Beirdo/arduino-webasto-mainboard/README.md

# arduino-webasto-mainboard
Custom replacement control board for Webasto Thermo Top C/E
