Beirdo/arduino-webasto-mainboard/firmware/webasto-mainboard/src/README.md

Along with the libraries included under this directory, the following
must be added in the Arduino IDE:

Boards:
- Raspberry Pi Pico/RP2040 by Earle F. Philhower III - v2.7.1
- choose Raspberry Pi Pico W

Libraries:
- Queue by SMFSW <xgarmanbozlax@gmail.com> - v1.11.0
- I2C\_EEPROM by Rob Tillaart <rob.tillaart@gmail.com> - v1.7.1
- ArduinoLog by Thijs Elenbaas - v1.1.1
- TinyCBOR by TOKITA Hiroshi - v0.5.3002
- SSD1306 stuff
- ACAN2517FD by Pierre Molinaro - v2.1.10

also, to populate this directory, you need:
- git submodule init
- get submodule update

Please don't forget to enable RTTI in the Tools menu.
