Beirdo/arduino-webasto-mainboard/docs/20230128_150927.jpg

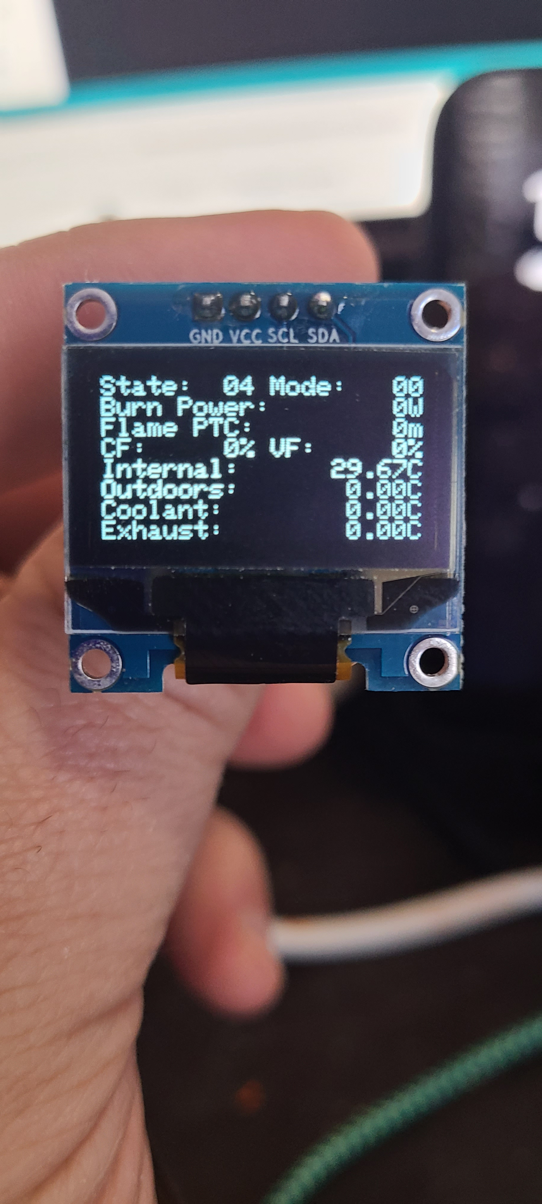
docs/20230128_150927.jpg
