Beirdo/arduino-webasto-mainboard/hardware/atx-power-fixture/schematic.pdf

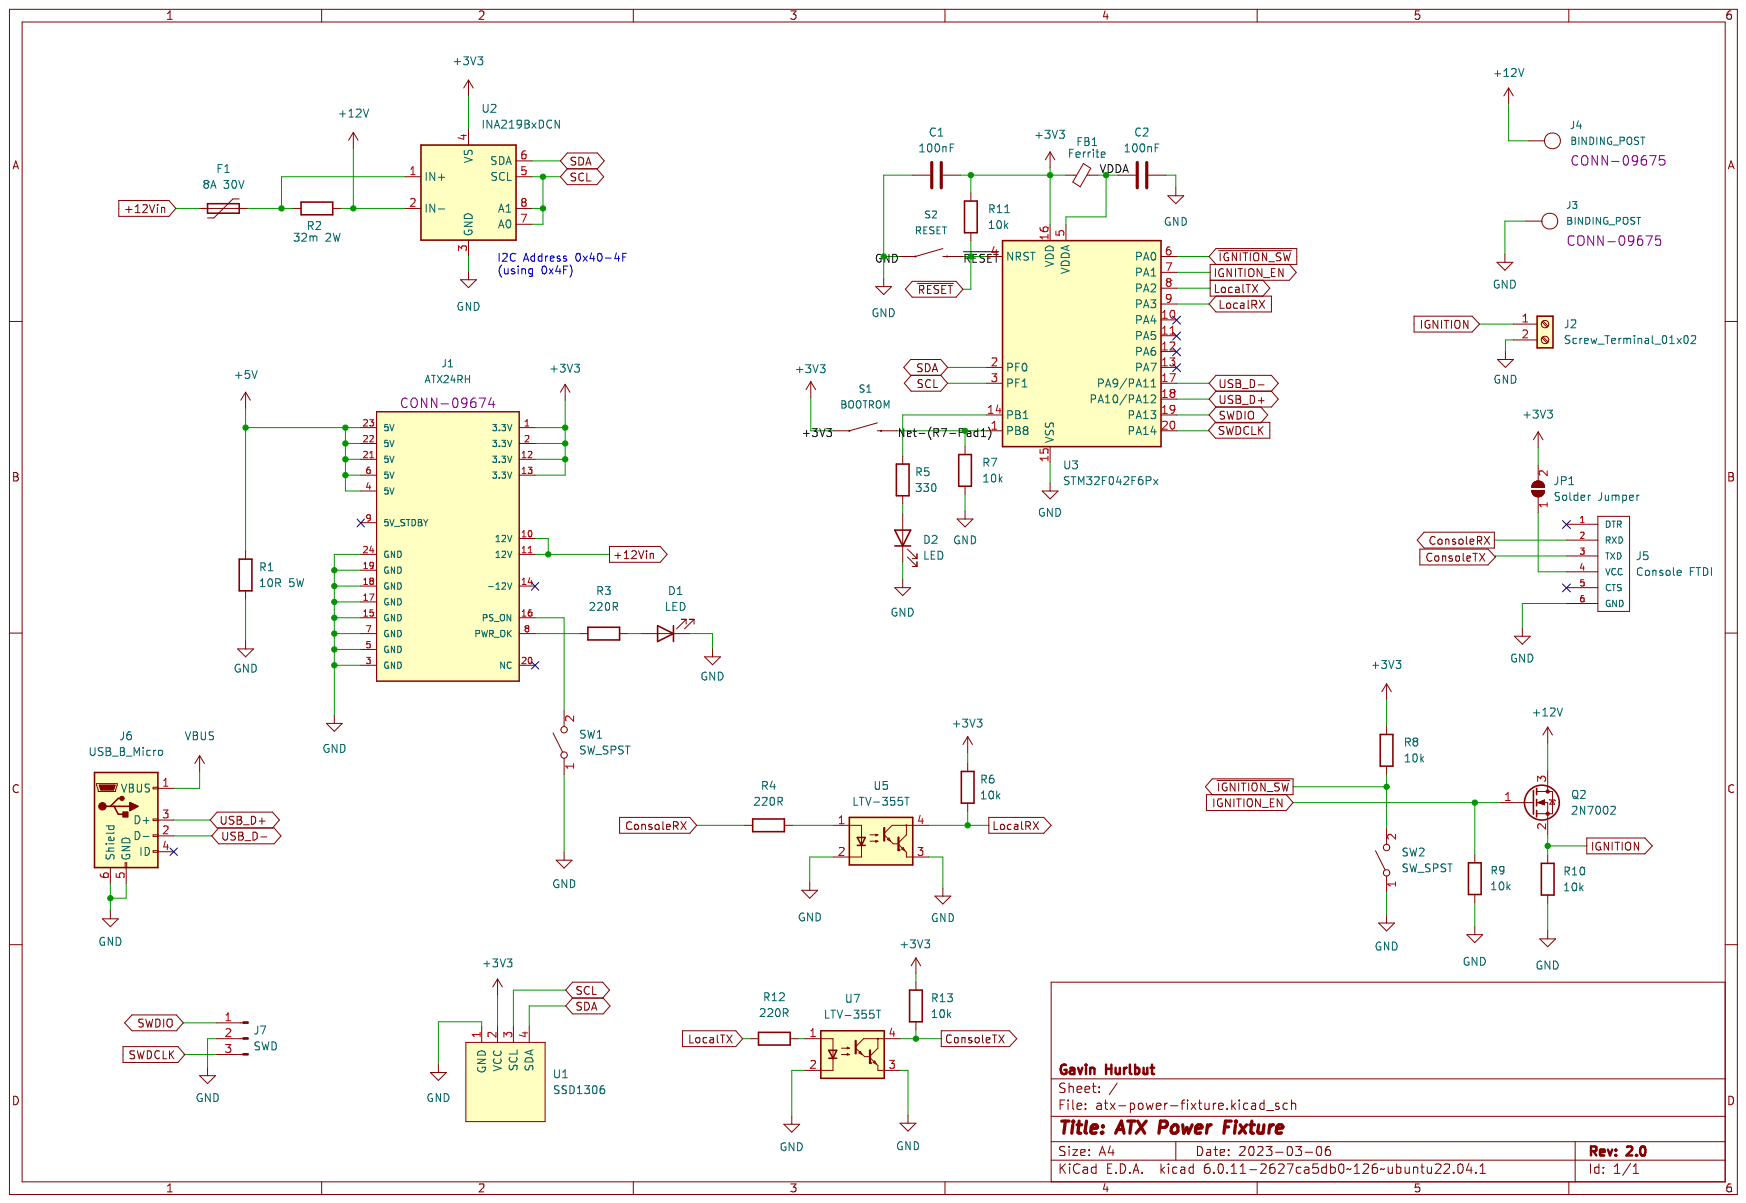
[picture p22: page 1]
