Beirdo/arduino-webasto-mainboard/(list of files, drawings)

Other design files:
docs/ngspice/CSD22204W.OLB
