Beirdo/arduino-webasto-mainboard/hardware/webasto-mainboard/webasto-mainboard.kicad_pcb

## KiCad design hardware/webasto-mainboard/webasto-mainboard.kicad_pcb (2023-03-08)

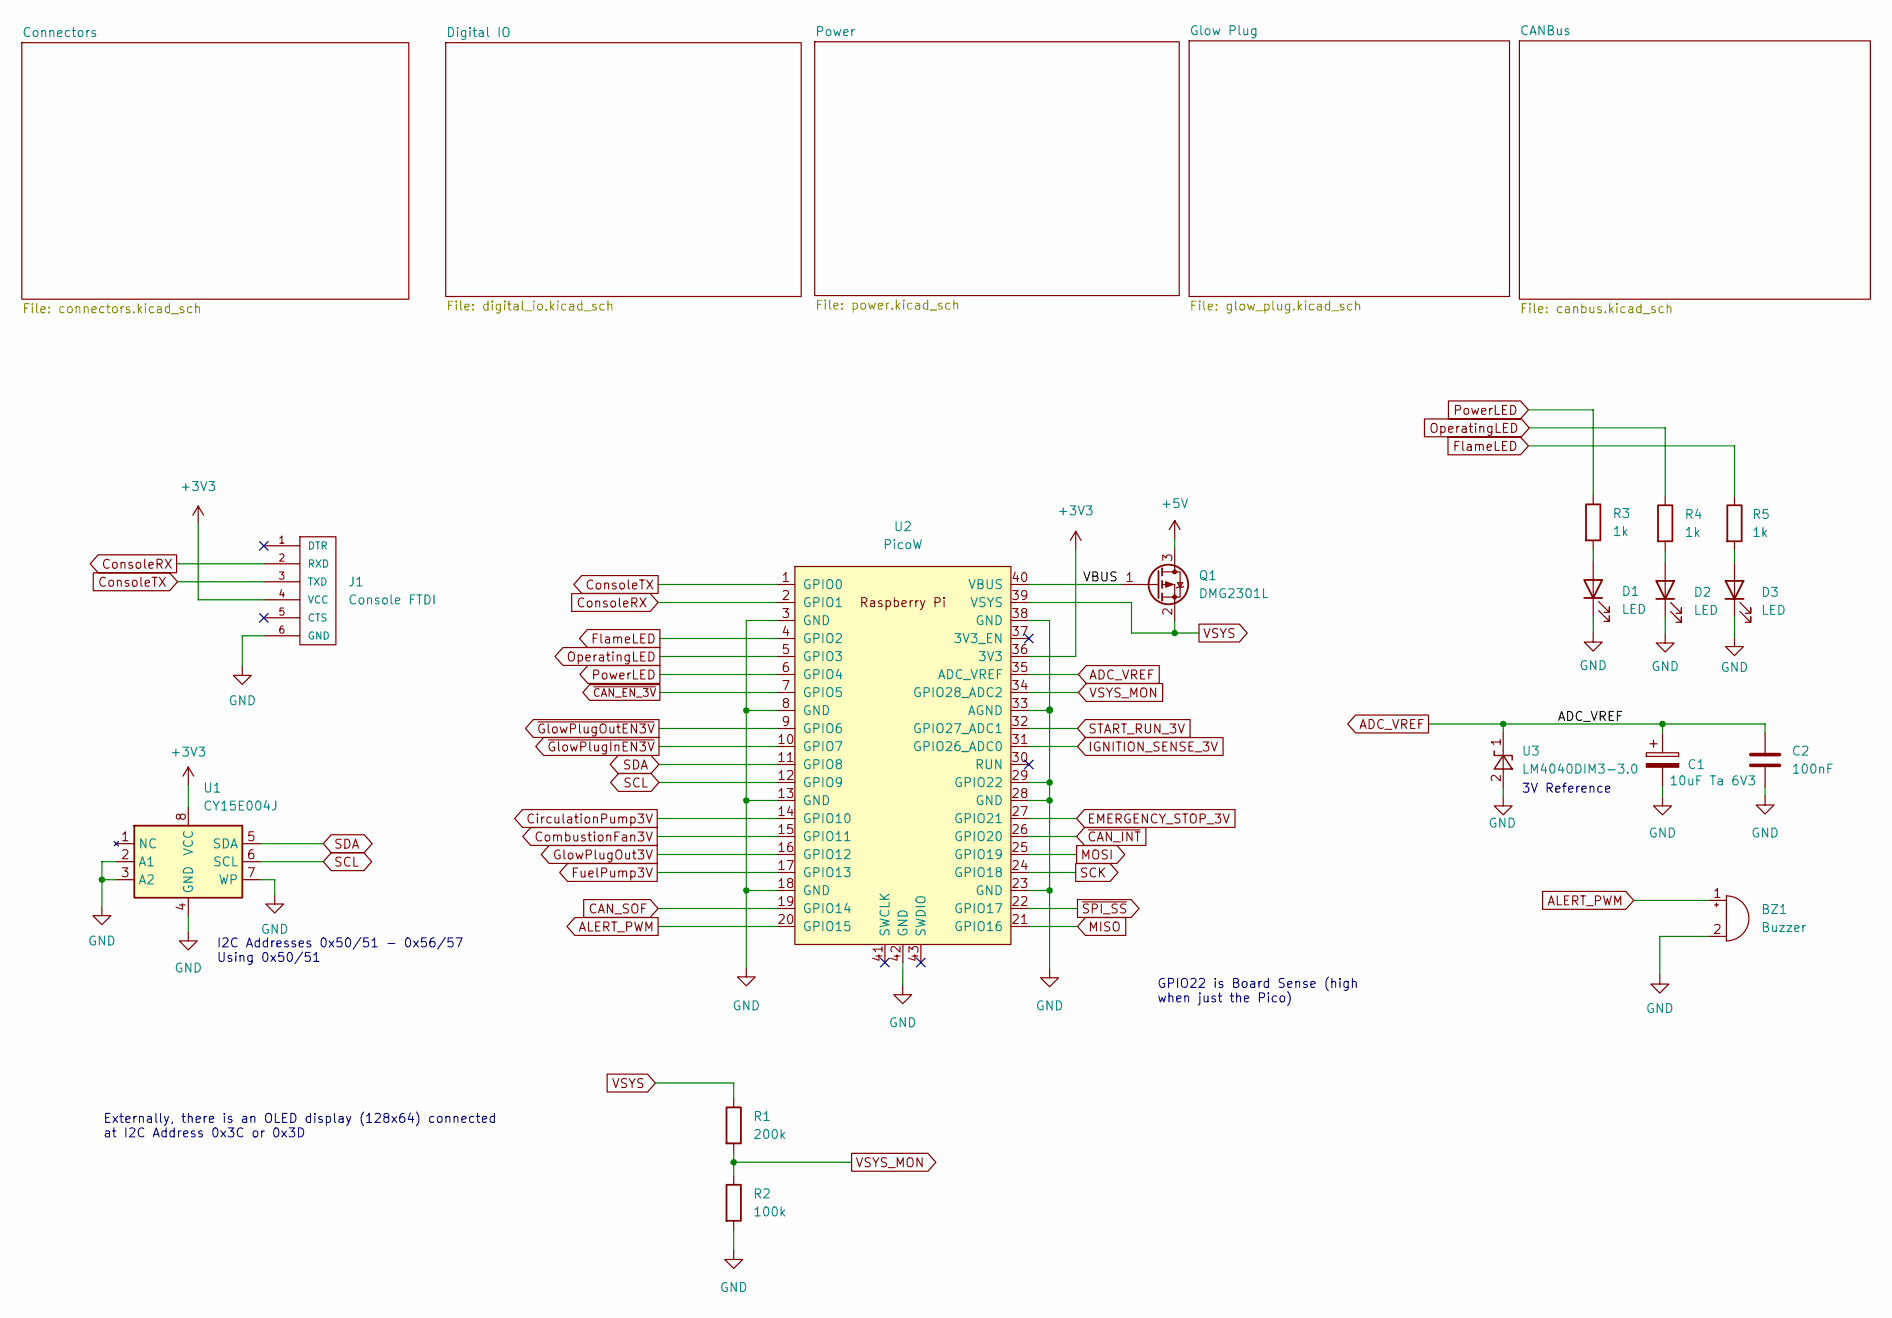
[picture p23: schematic webasto-mainboard.kicad_sch, Webasto Replacement Mainboard (Thermo Top C)]

Parts:
BZ1: Buzzer; Buzzer_TDK_PS1240P02BT_D12.2mm_H6.5mm
C1: 10uF Ta 6V3; CP_EIA-3216-10_Kemet-I_Pad1.58x1.35mm_HandSolder
C2: 100nF; C_0805_2012Metric_Pad1.18x1.45mm_HandSolder
D1, D2, D3: LED; LED_0805_2012Metric_Pad1.15x1.40mm_HandSolder
J1: Console FTDI; FTDI-TARGET
Q1: DMG2301L; SOT-23
R1: 200k; R_0805_2012Metric_Pad1.20x1.40mm_HandSolder
R2: 100k; R_0805_2012Metric_Pad1.20x1.40mm_HandSolder
R3, R4, R5: 1k; R_0805_2012Metric_Pad1.20x1.40mm_HandSolder
U1: CY15E004J; SOIC-8_5.23x5.23mm_P1.27mm
U2: PicoW; RPi_Pico_SMD_TH
U3: LM4040DIM3-3.0; SOT-23

Connections:
+3V3: J1.4 (VCC), U1.8 (VCC), U2.36 (3V3); also elsewhere on the board
+5V: Q1.3 (D); also elsewhere on the board
/VBUS: Q1.1 (G), U2.40 (VBUS)
ADC_VREF: C1.1, C2.1, U2.35 (ADC_VREF), U3.1 (K)
ALERT_PWM: BZ1.1 (-), U2.20 (GPIO15)
CAN_SOF: U2.19 (GPIO14); also elsewhere on the board
CirculationPump3V: U2.14 (GPIO10); also elsewhere on the board
CombustionFan3V: U2.15 (GPIO11); also elsewhere on the board
ConsoleRX: J1.2 (RXD), U2.2 (GPIO1)
ConsoleTX: J1.3 (TXD), U2.1 (GPIO0)
EMERGENCY_STOP_3V: U2.27 (GPIO21); also elsewhere on the board
FlameLED: R5.1, U2.4 (GPIO2)
FuelPump3V: U2.17 (GPIO13); also elsewhere on the board
GND: BZ1.2 (+), C1.2, C2.2, D1.1 (K), D2.1 (K), D3.1 (K), J1.6 (GND), R2.2, U1.2 (A1), U1.3 (A2), U1.4 (GND), U1.7 (WP), U2.3 (GND), U2.8 (GND), U2.13 (GND), U2.18 (GND), U2.23 (GND), U2.28 (GND), U2.29 (GPIO22), U2.33 (AGND), U2.42 (GND), U3.2 (A); also elsewhere on the board
GlowPlugOut3V: U2.16 (GPIO12); also elsewhere on the board
IGNITION_SENSE_3V: U2.31 (GPIO26_ADC0); also elsewhere on the board
MISO: U2.21 (GPIO16); also elsewhere on the board
MOSI: U2.25 (GPIO19); also elsewhere on the board
unnamed: D1.2 (A), R3.2
unnamed: D2.2 (A), R4.2
unnamed: D3.2 (A), R5.2
OperatingLED: R4.1, U2.5 (GPIO3)
PowerLED: R3.1, U2.6 (GPIO4)
SCK: U2.24 (GPIO18); also elsewhere on the board
SCL: U1.6 (SCL), U2.12 (GPIO9); also elsewhere on the board
SDA: U1.5 (SDA), U2.11 (GPIO8); also elsewhere on the board
START_RUN_3V: U2.32 (GPIO27_ADC1); also elsewhere on the board
VSYS: Q1.2 (S), R1.1, U2.39 (VSYS)
VSYS_MON: R1.2, R2.1, U2.34 (GPIO28_ADC2)
~CAN_EN_3V: U2.7 (GPIO5); also elsewhere on the board
~CAN_INT: U2.26 (GPIO20); also elsewhere on the board
~GlowPlugInEN3V: U2.10 (GPIO7); also elsewhere on the board
~GlowPlugOutEN3V: U2.9 (GPIO6); also elsewhere on the board
~SPI_SS: U2.22 (GPIO17); also elsewhere on the board

Notes on the sheet:
I2C Addresses 0x50/51 - 0x56/57 Using 0x50/51
GPIO22 is Board Sense (high when just the Pico)
Externally, there is an OLED display (128x64) connected at I2C Address 0x3C or 0x3D
3V Reference

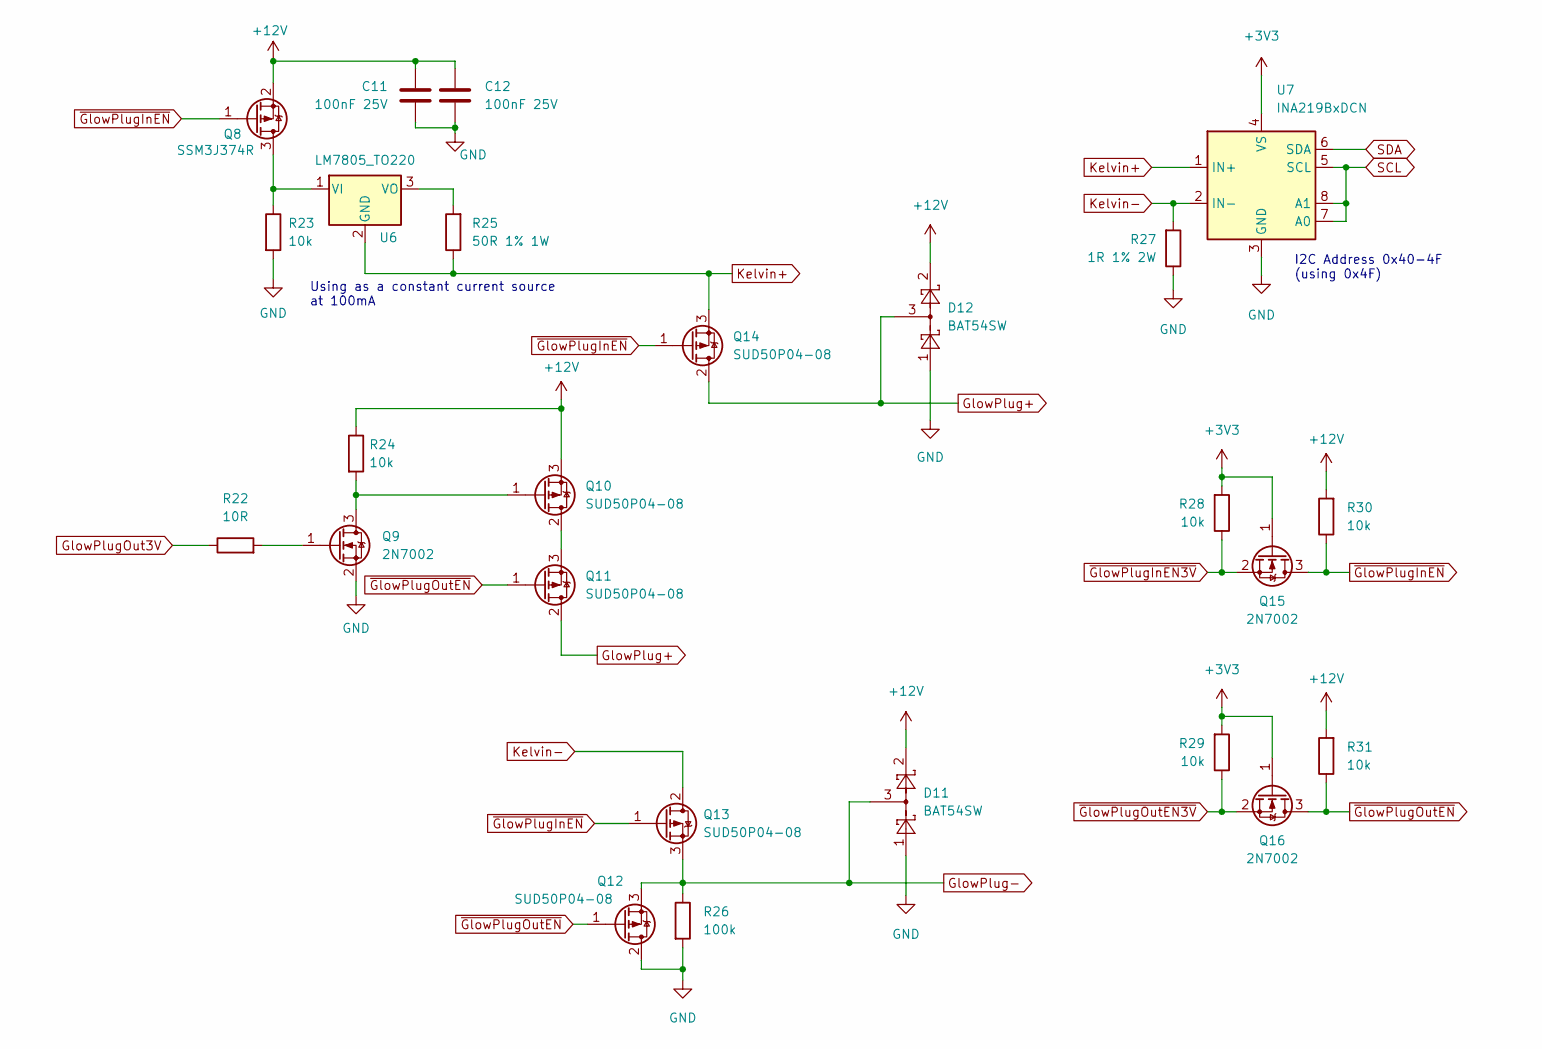
[picture p24: schematic glow_plug.kicad_sch, Webasto Replacement Mainboard (Thermo Top C)]

Parts:
C11, C12: 100nF 25V; C_0805_2012Metric_Pad1.18x1.45mm_HandSolder
D11, D12: BAT54SW; SOT-323_SC-70
Q8: SSM3J374R; SOT-23
Q9, Q15, Q16: 2N7002; SOT-23
Q10, Q11, Q12, Q13, Q14: SUD50P04-08; TO-252-2
R22: 10R; R_0805_2012Metric_Pad1.20x1.40mm_HandSolder
R23, R24, R28, R29, R30, R31: 10k; R_0805_2012Metric_Pad1.20x1.40mm_HandSolder
R25: 50R 1% 1W; R_2816_7142Metric_Pad3.20x4.45mm_HandSolder
R26: 100k; R_0805_2012Metric_Pad1.20x1.40mm_HandSolder
R27: 1R 1% 2W; R_2512_6332Metric_Pad1.40x3.35mm_HandSolder
U6: LM7805_TO220; TO-220-3_Vertical
U7: INA219BxDCN; SOT-23-8

Connections:
+3V3: Q15.1 (G), Q16.1 (G), R28.2, R29.2, U7.4 (VS); also elsewhere on the board
+12V: C11.2, C12.2, D11.2, D12.2, Q8.2 (S), Q10.3 (S), R24.1, R30.2, R31.2; also elsewhere on the board
GND: C11.1, C12.1, D11.1, D12.1, Q9.2 (S), Q12.2 (D), R23.2, R26.2, R27.1, U7.3 (GND); also elsewhere on the board
GlowPlug+: D12.3, Q11.2 (D), Q14.2 (D); also elsewhere on the board
GlowPlug-: D11.3, Q12.3 (S), Q13.3 (S), R26.1; also elsewhere on the board
GlowPlugOut3V: R22.1; also elsewhere on the board
Kelvin+: Q14.3 (S), R25.1, U6.2 (GND), U7.1 (IN+)
Kelvin-: Q13.2 (D), R27.2, U7.2 (IN-)
unnamed: Q8.3 (D), R23.1, U6.1 (VI)
unnamed: Q9.1 (G), R22.2
unnamed: Q9.3 (D), Q10.1 (G), R24.2
unnamed: Q10.2 (D), Q11.3 (S)
unnamed: R25.2, U6.3 (VO)
SCL: U7.5 (SCL), U7.7 (A0), U7.8 (A1); also elsewhere on the board
SDA: U7.6 (SDA); also elsewhere on the board
~GlowPlugInEN3V: Q15.2 (S), R28.1; also elsewhere on the board
~GlowPlugInEN: Q8.1 (G), Q13.1 (G), Q14.1 (G), Q15.3 (D), R30.1
~GlowPlugOutEN3V: Q16.2 (S), R29.1; also elsewhere on the board
~GlowPlugOutEN: Q11.1 (G), Q12.1 (G), Q16.3 (D), R31.1

Notes on the sheet:
I2C Address 0x40-4F (using 0x4F)
Using as a constant current source at 100mA

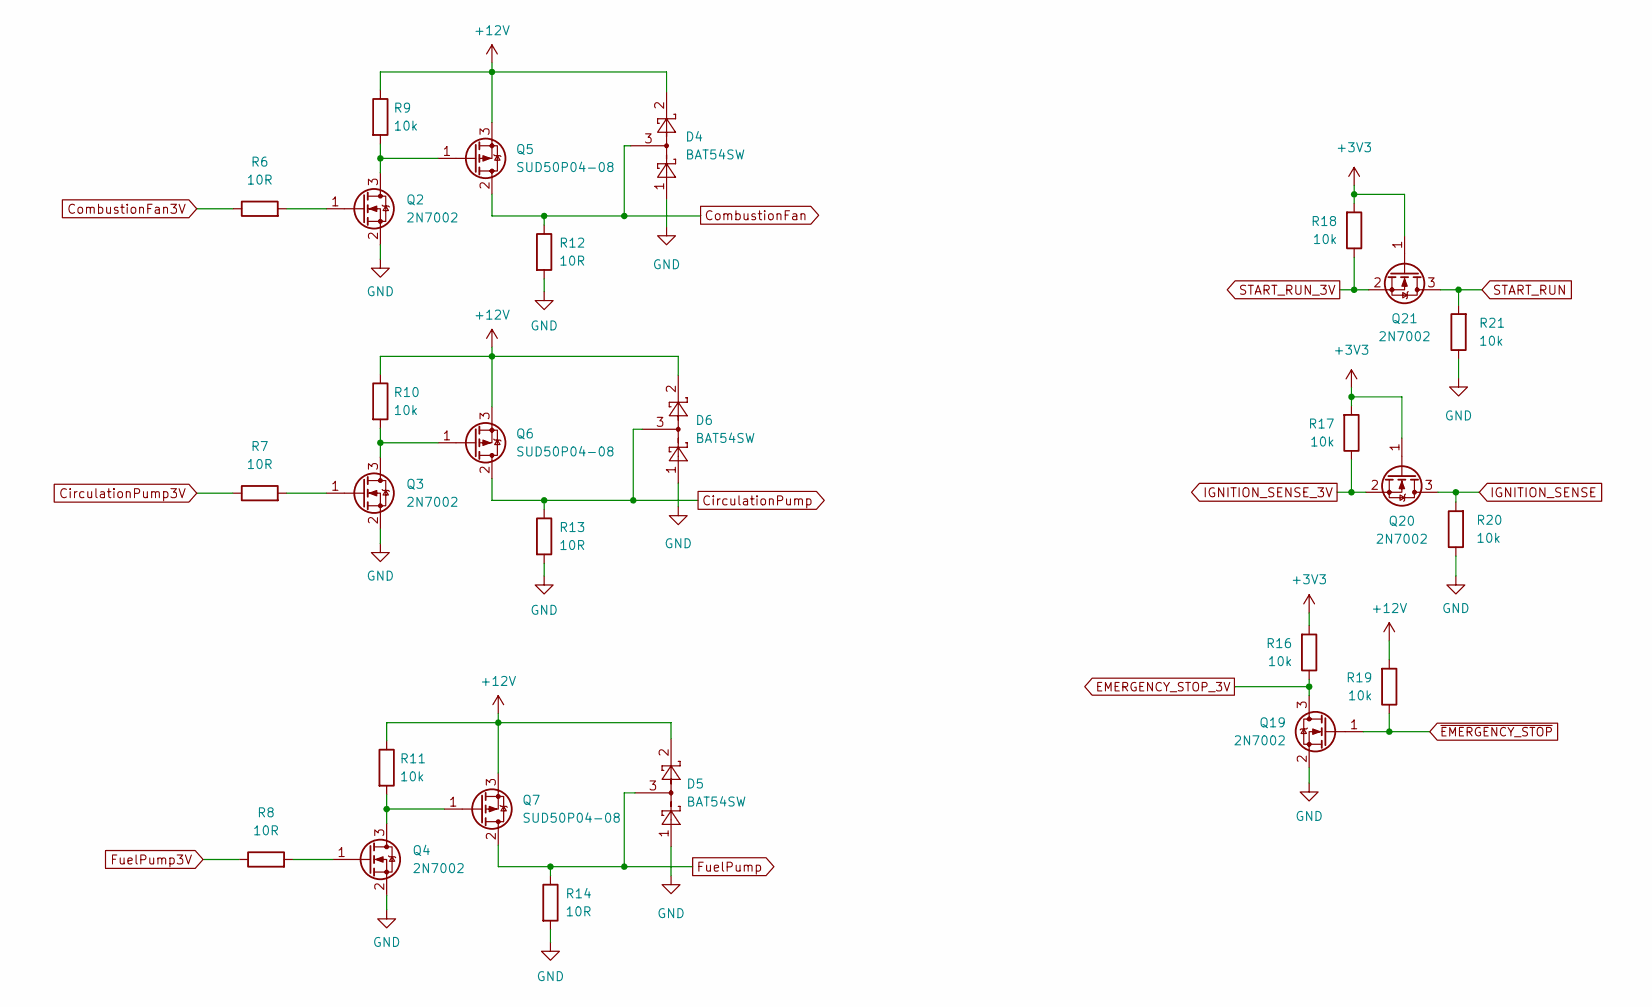
[picture p25: schematic digital_io.kicad_sch, Webasto Replacement Mainboard (Thermo Top C)]

Parts:
D4, D5, D6: BAT54SW; SOT-323_SC-70
Q2, Q3, Q4, Q19, Q20, Q21: 2N7002; SOT-23
Q5, Q6, Q7: SUD50P04-08; TO-252-2
R6, R7, R8, R12, R13, R14: 10R; R_0805_2012Metric_Pad1.20x1.40mm_HandSolder
R9, R10, R11, R16, R17, R18, R19, R20, R21: 10k; R_0805_2012Metric_Pad1.20x1.40mm_HandSolder

Connections:
+3V3: Q20.1 (G), Q21.1 (G), R16.2, R17.2, R18.2; also elsewhere on the board
+12V: D4.2, D5.2, D6.2, Q5.3 (S), Q6.3 (S), Q7.3 (S), R9.1, R10.1, R11.1, R19.2; also elsewhere on the board
CirculationPump: D6.3, Q6.2 (D), R13.1; also elsewhere on the board
CirculationPump3V: R7.1; also elsewhere on the board
CombustionFan: D4.3, Q5.2 (D), R12.1; also elsewhere on the board
CombustionFan3V: R6.1; also elsewhere on the board
EMERGENCY_STOP_3V: Q19.3 (D), R16.1; also elsewhere on the board
FuelPump: D5.3, Q7.2 (D), R14.1; also elsewhere on the board
FuelPump3V: R8.1; also elsewhere on the board
GND: D4.1, D5.1, D6.1, Q2.2 (S), Q3.2 (S), Q4.2 (S), Q19.2 (S), R12.2, R13.2, R14.2, R20.1, R21.1; also elsewhere on the board
IGNITION_SENSE: Q20.3 (D), R20.2; also elsewhere on the board
IGNITION_SENSE_3V: Q20.2 (S), R17.1; also elsewhere on the board
unnamed: Q2.1 (G), R6.2
unnamed: Q2.3 (D), Q5.1 (G), R9.2
unnamed: Q3.1 (G), R7.2
unnamed: Q3.3 (D), Q6.1 (G), R10.2
unnamed: Q4.1 (G), R8.2
unnamed: Q4.3 (D), Q7.1 (G), R11.2
START_RUN: Q21.3 (D), R21.2; also elsewhere on the board
START_RUN_3V: Q21.2 (S), R18.1; also elsewhere on the board
~EMERGENCY_STOP: Q19.1 (G), R19.1; also elsewhere on the board

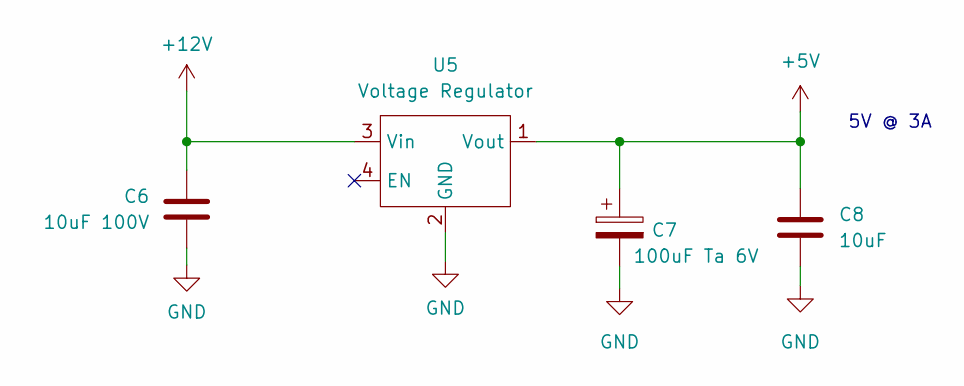
[picture p26: schematic power.kicad_sch, Webasto Replacement Mainboard (Thermo Top C)]

Parts:
C6: 10uF 100V; C_1210_3225Metric_Pad1.33x2.70mm_HandSolder
C7: 100uF Ta 6V; CP_EIA-3216-10_Kemet-I_Pad1.58x1.35mm_HandSolder
C8: 10uF; C_0805_2012Metric_Pad1.18x1.45mm_HandSolder
U5: Voltage Regulator; Switching_Regulator_Module

Connections:
+5V: C7.1, C8.1, U5.1 (Vout); also elsewhere on the board
+12V: C6.1, U5.3 (Vin); also elsewhere on the board
GND: C6.2, C7.2, C8.2, U5.2 (GND); also elsewhere on the board

Notes on the sheet:
5V @ 3A

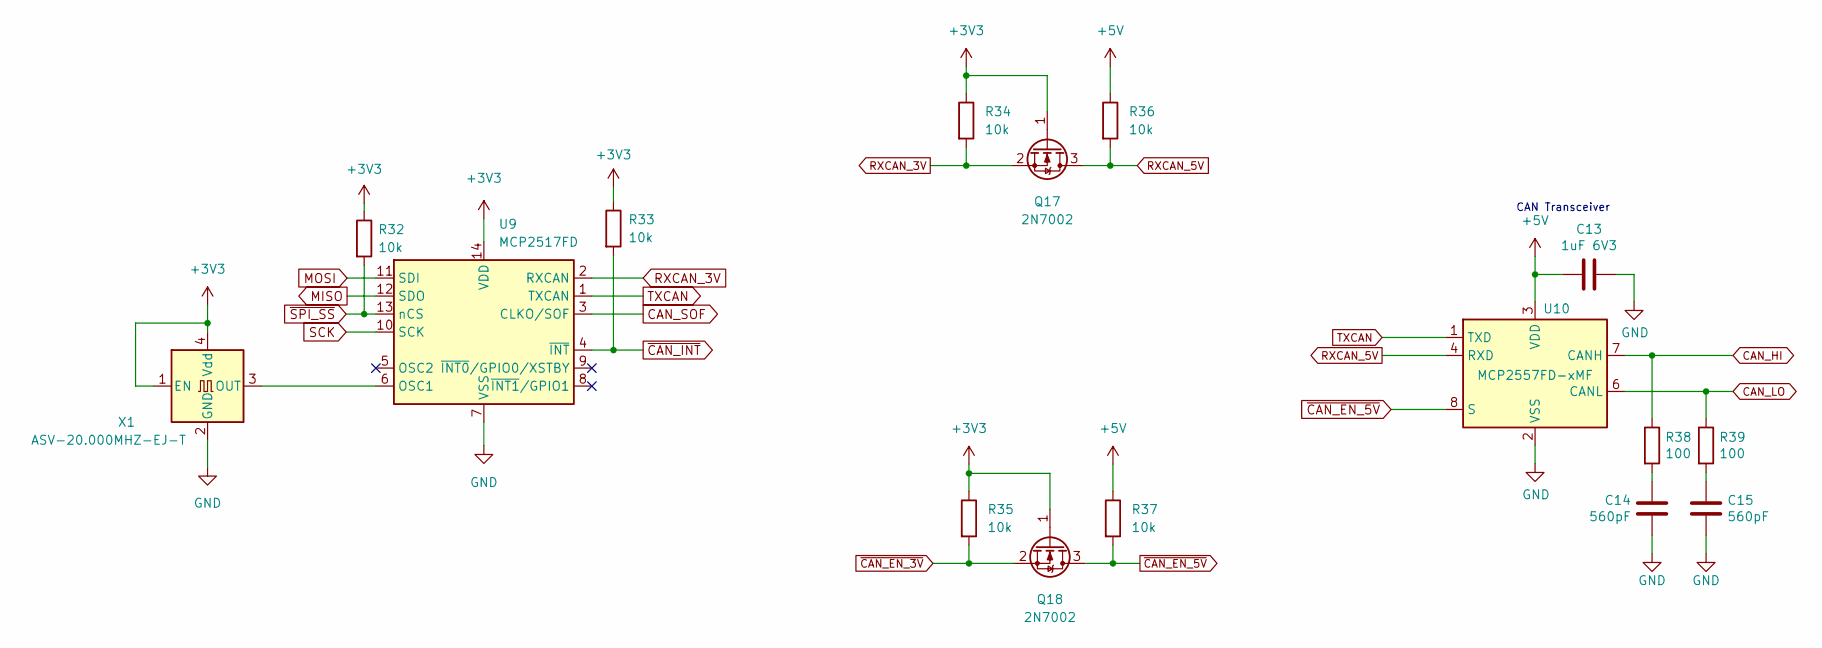
[picture p27: schematic canbus.kicad_sch, Webasto Replacement Mainboard (Thermo Top C)]

Parts:
C13: 1uF 6V3; C_0805_2012Metric_Pad1.18x1.45mm_HandSolder
C14, C15: 560pF; C_0805_2012Metric_Pad1.18x1.45mm_HandSolder
Q17, Q18: 2N7002; SOT-23
R32, R33, R34, R35, R36, R37: 10k; R_0805_2012Metric_Pad1.20x1.40mm_HandSolder
R38, R39: 100; R_0805_2012Metric_Pad1.20x1.40mm_HandSolder
U9: MCP2517FD; SOIC-14_3.9x8.7mm_P1.27mm
U10: MCP2557FD-xMF; SOIC-8_3.9x4.9mm_P1.27mm
X1: ASV-20.000MHZ-EJ-T; Oscillator_SMD_Abracon_ASV-4Pin_7.0x5.1mm

Connections:
+3V3: Q17.1 (G), Q18.1 (G), R32.1, R33.1, R34.1, R35.1, U9.14 (VDD), X1.1 (EN), X1.4 (Vdd); also elsewhere on the board
+5V: C13.2, R36.1, R37.1, U10.3 (VDD); also elsewhere on the board
CAN_HI: R38.1, U10.7 (CANH); also elsewhere on the board
CAN_LO: R39.1, U10.6 (CANL); also elsewhere on the board
CAN_SOF: U9.3 (CLKO/SOF); also elsewhere on the board
GND: C13.1, C14.1, C15.2, U9.7 (VSS), U10.2 (VSS), U10.9 (VSS), X1.2 (GND); also elsewhere on the board
MISO: U9.12 (SDO); also elsewhere on the board
MOSI: U9.11 (SDI); also elsewhere on the board
unnamed: C14.2, R38.2
unnamed: C15.1, R39.2
unnamed: U9.6 (OSC1), X1.3 (OUT)
RXCAN_3V: Q17.2 (S), R34.2, U9.2 (RXCAN)
RXCAN_5V: Q17.3 (D), R36.2, U10.4 (RXD)
SCK: U9.10 (SCK); also elsewhere on the board
TXCAN: U9.1 (TXCAN), U10.1 (TXD)
~CAN_EN_3V: Q18.2 (S), R35.2; also elsewhere on the board
~CAN_EN_5V: Q18.3 (D), R37.2, U10.8 (S)
~CAN_INT: R33.2, U9.4 (~INT); also elsewhere on the board
~SPI_SS: R32.2, U9.13 (nCS); also elsewhere on the board

Notes on the sheet:
CAN Transceiver

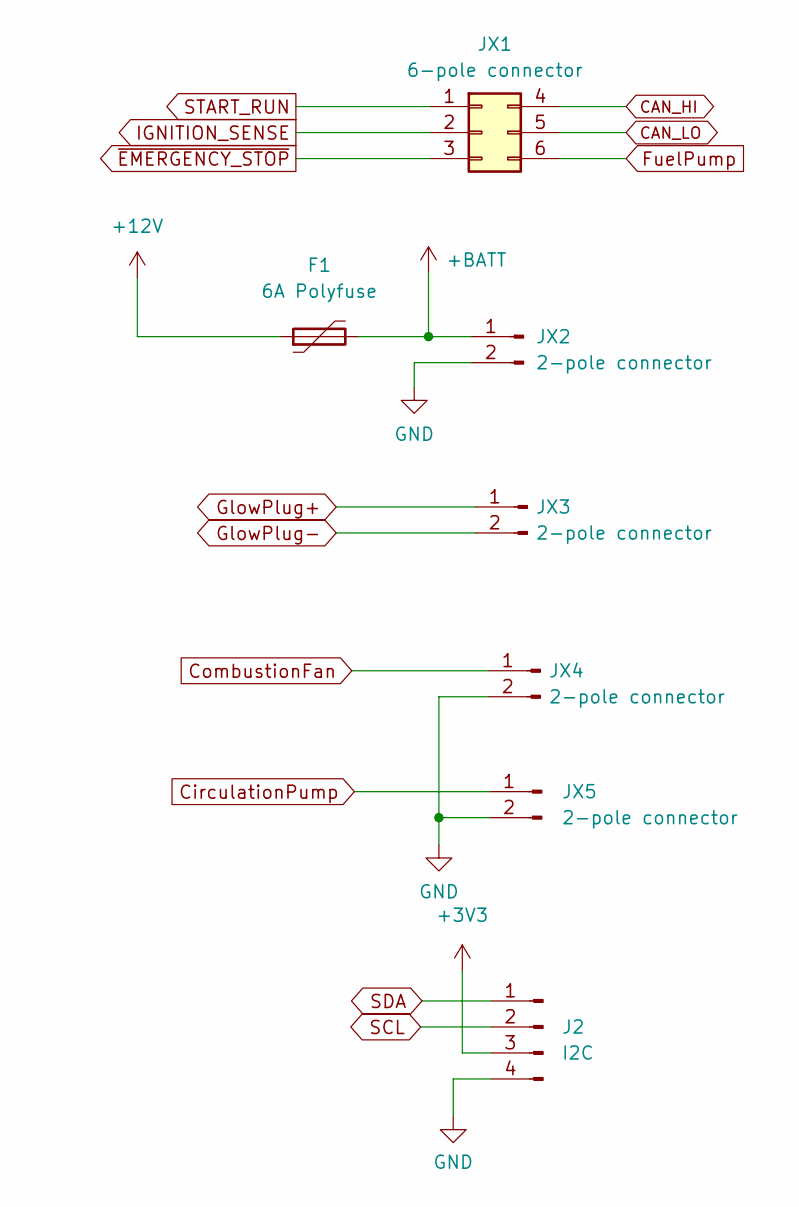
[picture p28: schematic connectors.kicad_sch, Webasto Replacement Mainboard (Thermo Top C)]

Parts:
F1: 6A Polyfuse; R_1812_4532Metric_Pad1.30x3.40mm_HandSolder; Digikey F2772CT-ND
J2: I2C; PinHeader_1x04_P2.54mm_Vertical
JX1: 6-pole connector; Webasto_Therma_Top_C_X1
JX2: 2-pole connector; Webasto_Therma_Top_C_X2
JX3: 2-pole connector; Webasto_Therma_Top_C_X3
JX4, JX5: 2-pole connector; Webasto_Therma_Top_C_X4X5

Connections:
+3V3: J2.3; also elsewhere on the board
+12V: F1.1; also elsewhere on the board
+BATT: F1.2, JX2.1
CAN_HI: JX1.4; also elsewhere on the board
CAN_LO: JX1.5; also elsewhere on the board
CirculationPump: JX5.1; also elsewhere on the board
CombustionFan: JX4.1; also elsewhere on the board
FuelPump: JX1.6; also elsewhere on the board
GND: J2.4, JX2.2, JX4.2, JX5.2; also elsewhere on the board
GlowPlug+: JX3.1; also elsewhere on the board
GlowPlug-: JX3.2; also elsewhere on the board
IGNITION_SENSE: JX1.2; also elsewhere on the board
SCL: J2.2; also elsewhere on the board
SDA: J2.1; also elsewhere on the board
START_RUN: JX1.1; also elsewhere on the board
~EMERGENCY_STOP: JX1.3; also elsewhere on the board

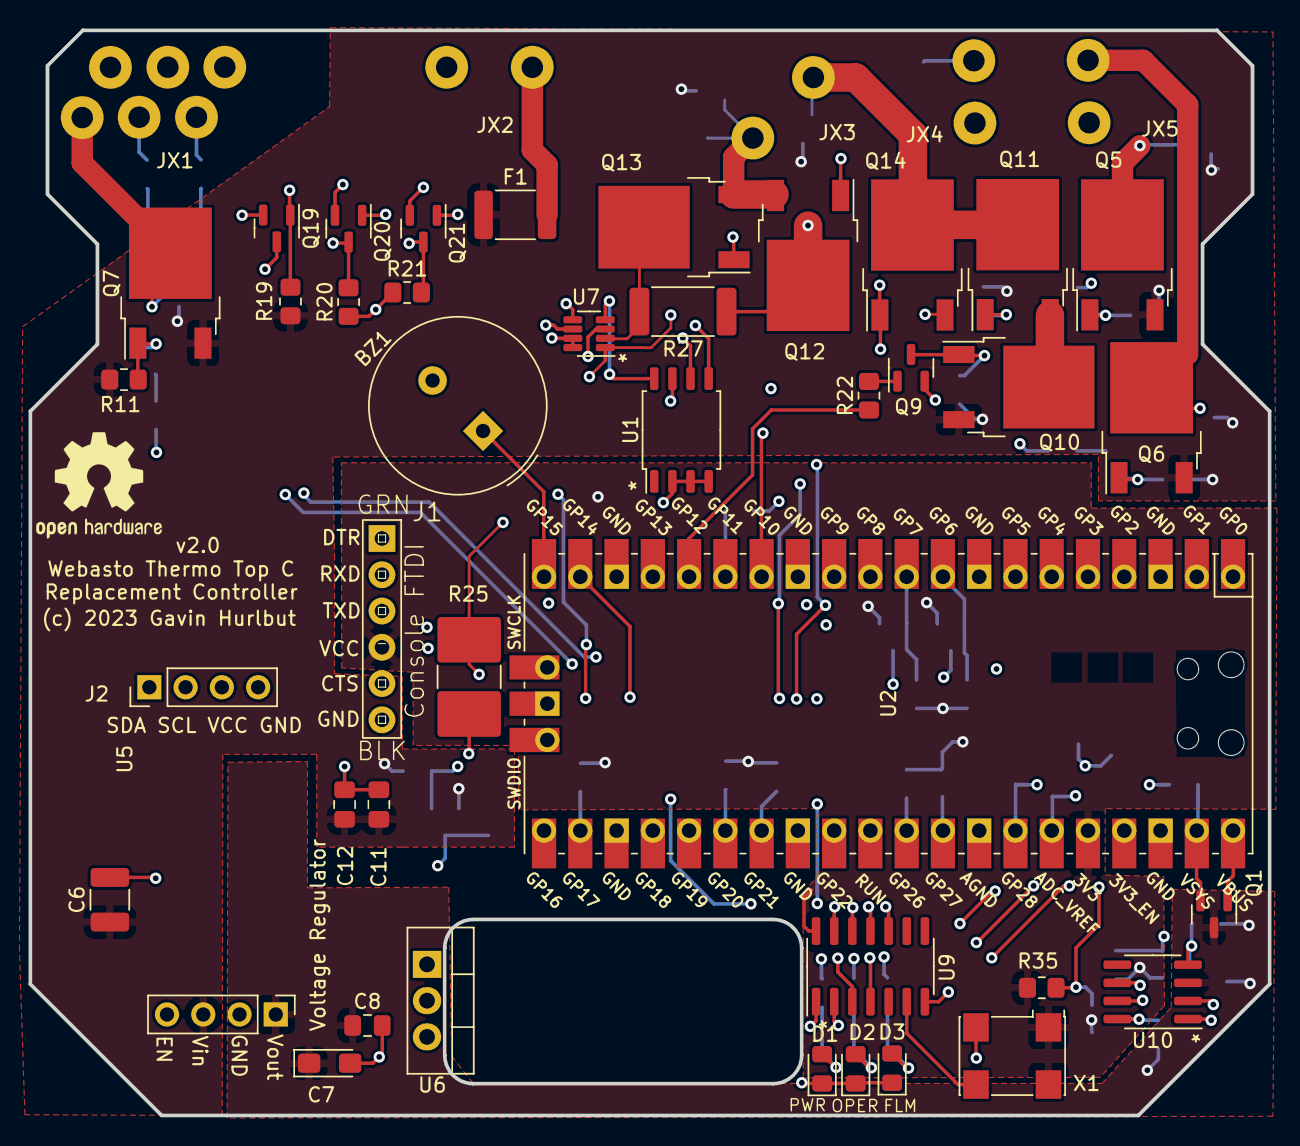
[picture p29: board webasto-mainboard.kicad_pcb from above]

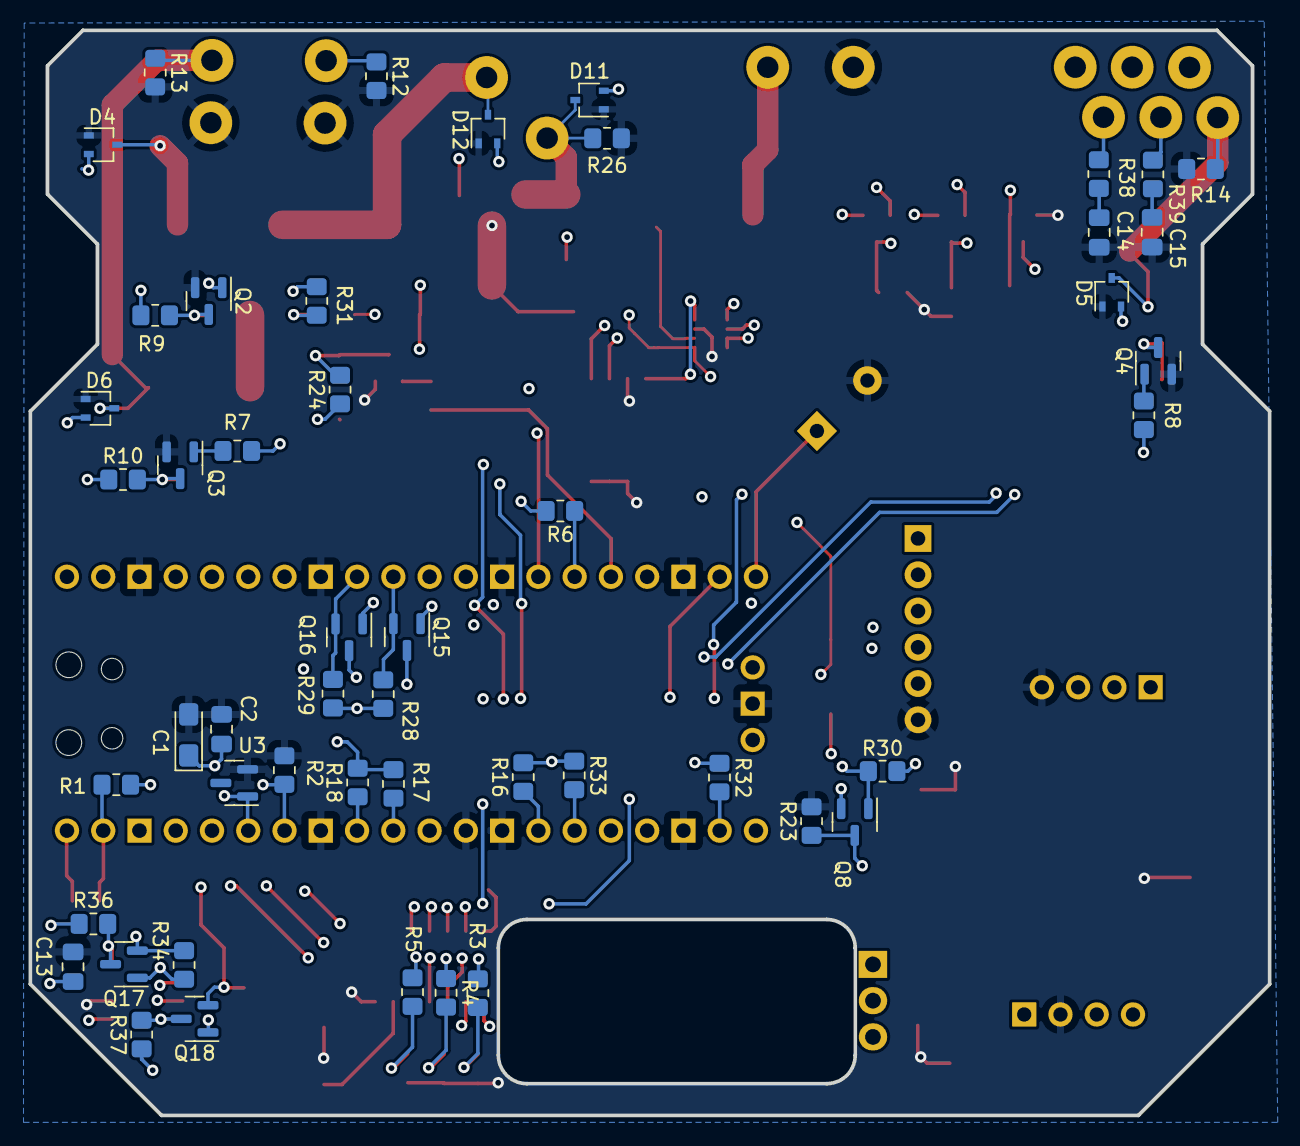
[picture p30: board webasto-mainboard.kicad_pcb from below]

Board: 4 copper layers, 86.8 x 76.0 mm, 95 parts (49 on the bottom side), 68 nets.
