Beirdo/arduino-webasto-mainboard/hardware/atx-power-fixture/atx-power-fixture.kicad_pcb

## KiCad design hardware/atx-power-fixture/atx-power-fixture.kicad_pcb (2023-03-07)

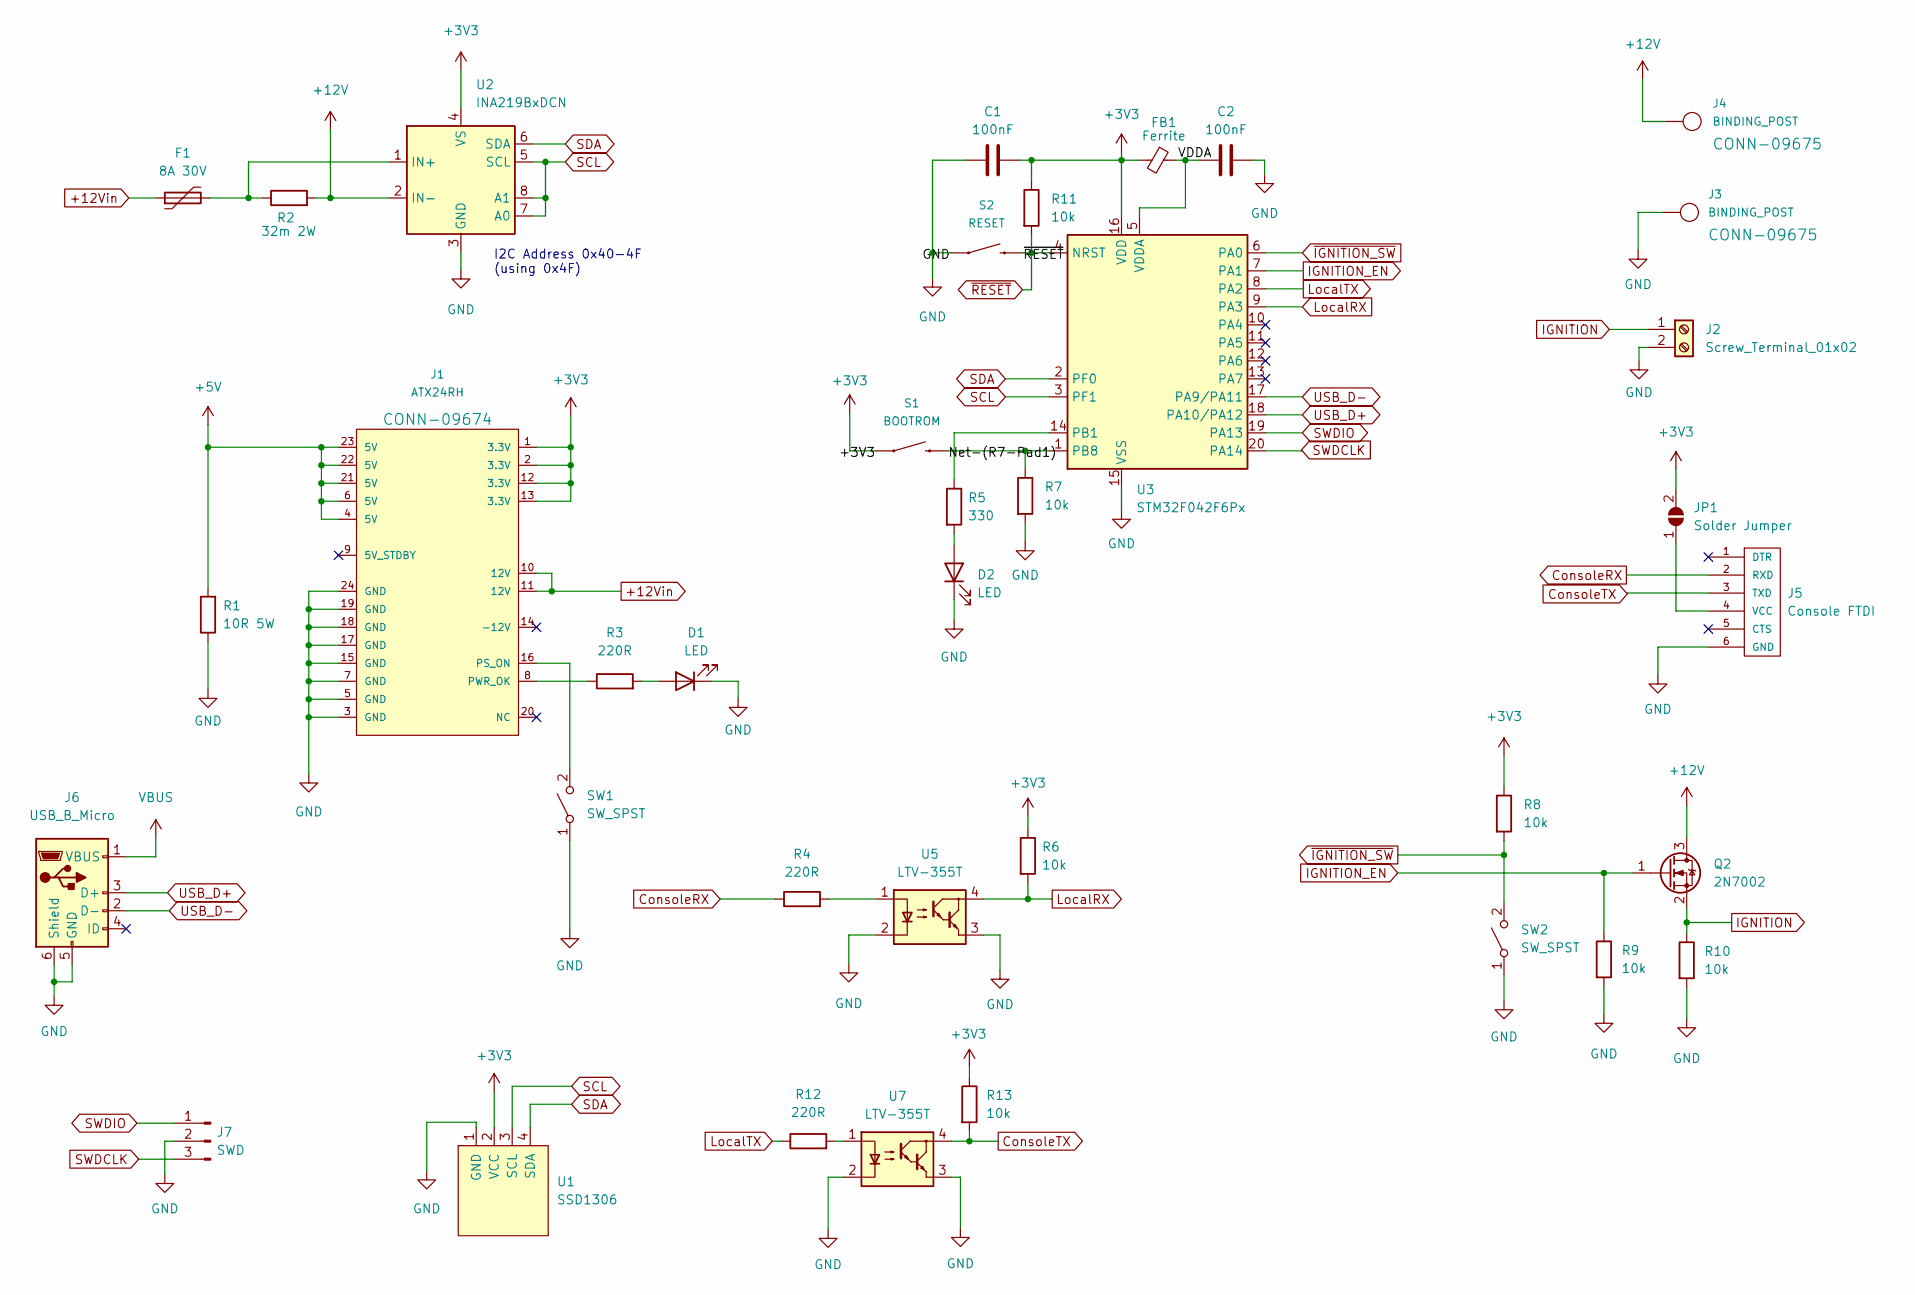
[picture p31: schematic atx-power-fixture.kicad_sch, ATX Power Fixture]

Parts:
C1, C2: 100nF; C_0805_2012Metric_Pad1.18x1.45mm_HandSolder
D1: LED; LED_D3.0mm
D2: LED; LED_0805_2012Metric_Pad1.15x1.40mm_HandSolder
F1: 8A 30V; Fuse_Littelfuse_372_D8.50mm
FB1: Ferrite; L_0805_2012Metric_Pad1.15x1.40mm_HandSolder
J1: ATX24RH; ATX24_RIGHT_ANGLE
J2: Screw_Terminal_01x02; TerminalBlock_TE_282834-2_1x02_P2.54mm_Horizontal
J3, J4: BINDING_POST
J5: Console FTDI; FTDI-TARGET
J6: USB_B_Micro; USB_Micro-B_Amphenol_10118194_Horizontal
J7: SWD; PinHeader_1x03_P2.54mm_Vertical
JP1: Solder Jumper; SolderJumper-2_P1.3mm_Open_TrianglePad1.0x1.5mm
Q2: 2N7002; SOT-23
R1: 10R 5W; 355010RFT
R2: 32m 2W; R_1812_4532Metric_Pad1.30x3.40mm_HandSolder
R3, R4, R12: 220R; R_0805_2012Metric_Pad1.20x1.40mm_HandSolder
R5: 330; R_0805_2012Metric_Pad1.20x1.40mm_HandSolder
R6, R7, R8, R9, R10, R11, R13: 10k; R_0805_2012Metric_Pad1.20x1.40mm_HandSolder
S1: BOOTROM; TACTILE_SWITCH_PTH_6.0MM
S2: RESET; TACTILE_SWITCH_PTH_6.0MM
SW1, SW2: SW_SPST; SWITCH_SPDT_PTH_11.6X4.0MM
U1: SSD1306; 128x64OLED
U2: INA219BxDCN; SOT-23-8
U3: STM32F042F6Px; TSSOP-20_4.4x6.5mm_P0.65mm
U5, U7: LTV-355T; SO-4_4.4x3.6mm_P2.54mm

Connections:
+3V3: C1.2, FB1.2, J1.1 (3.3V), J1.2 (3.3V), J1.12 (3.3V), J1.13 (3.3V), JP1.2 (B), R6.1, R8.1, R11.1, R13.1, S1.1, S1.2 (1), U1.2 (VCC), U2.4 (VS), U3.16 (VDD)
+5V: J1.4 (5V), J1.6 (5V), J1.21 (5V), J1.22 (5V), J1.23 (5V), R1.2
+12V: J4.P$1, Q2.3 (D), R2.2, U2.2 (IN-)
+12Vin: F1.1, J1.10 (12V), J1.11 (12V)
/VDDA: C2.1, FB1.1, U3.5 (VDDA)
ConsoleRX: J5.2 (RXD), R4.1
ConsoleTX: J5.3 (TXD), R13.2, U7.4
GND: C1.1, C2.2, D1.1 (K), D2.1 (K), J1.3 (GND), J1.5 (GND), J1.7 (GND), J1.15 (GND), J1.17 (GND), J1.18 (GND), J1.19 (GND), J1.24 (GND), J2.2, J3.P$1, J5.6 (GND), J6.5 (GND), J6.6 (Shield), J7.2, R1.1, R7.2, R9.2, R10.2, S2.1, S2.2 (1), SW1.1 (A), SW2.1 (A), U1.1 (GND), U2.3 (GND), U3.15 (VSS), U5.2, U5.3, U7.2, U7.3
IGNITION: J2.1, Q2.2 (S), R10.1
IGNITION_EN: Q2.1 (G), R9.1, U3.7 (PA1)
LocalRX: R6.2, U3.9 (PA3), U5.4
LocalTX: R12.1, U3.8 (PA2)
unnamed: D1.2 (A), R3.2
unnamed: D2.2 (A), R5.2
unnamed: F1.2, R2.1, U2.1 (IN+)
unnamed: J1.8 (PWR_OK), R3.1
unnamed: J1.16 (PS_ON), SW1.2 (B)
unnamed: J5.4 (VCC), JP1.1 (A)
unnamed: R4.2, U5.1
unnamed: R5.1, U3.14 (PB1)
unnamed: R12.2, U7.1
SCL: U1.3 (SCL), U2.5 (SCL), U2.7 (A0), U2.8 (A1), U3.3 (PF1)
SDA: U1.4 (SDA), U2.6 (SDA), U3.2 (PF0)
SWDCLK: J7.3, U3.20 (PA14)
SWDIO: J7.1, U3.19 (PA13)
USB_D+: J6.3 (D+), U3.18 (PA10/PA12)
USB_D-: J6.2 (D-), U3.17 (PA9/PA11)
VBUS: J6.1 (VBUS)
~IGNITION_SW: R8.2, SW2.2 (B), U3.6 (PA0)
~RESET: R11.2, S2.3 (2), S2.4 (2), U3.4 (NRST)

Notes on the sheet:
I2C Address 0x40-4F (using 0x4F)

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
