Beirdo/arduino-webasto-mainboard/hardware/atx-power-fixture/atx-power-fixture.kicad_pcb

## KiCad design hardware/atx-power-fixture/atx-power-fixture.kicad_pcb (continued)

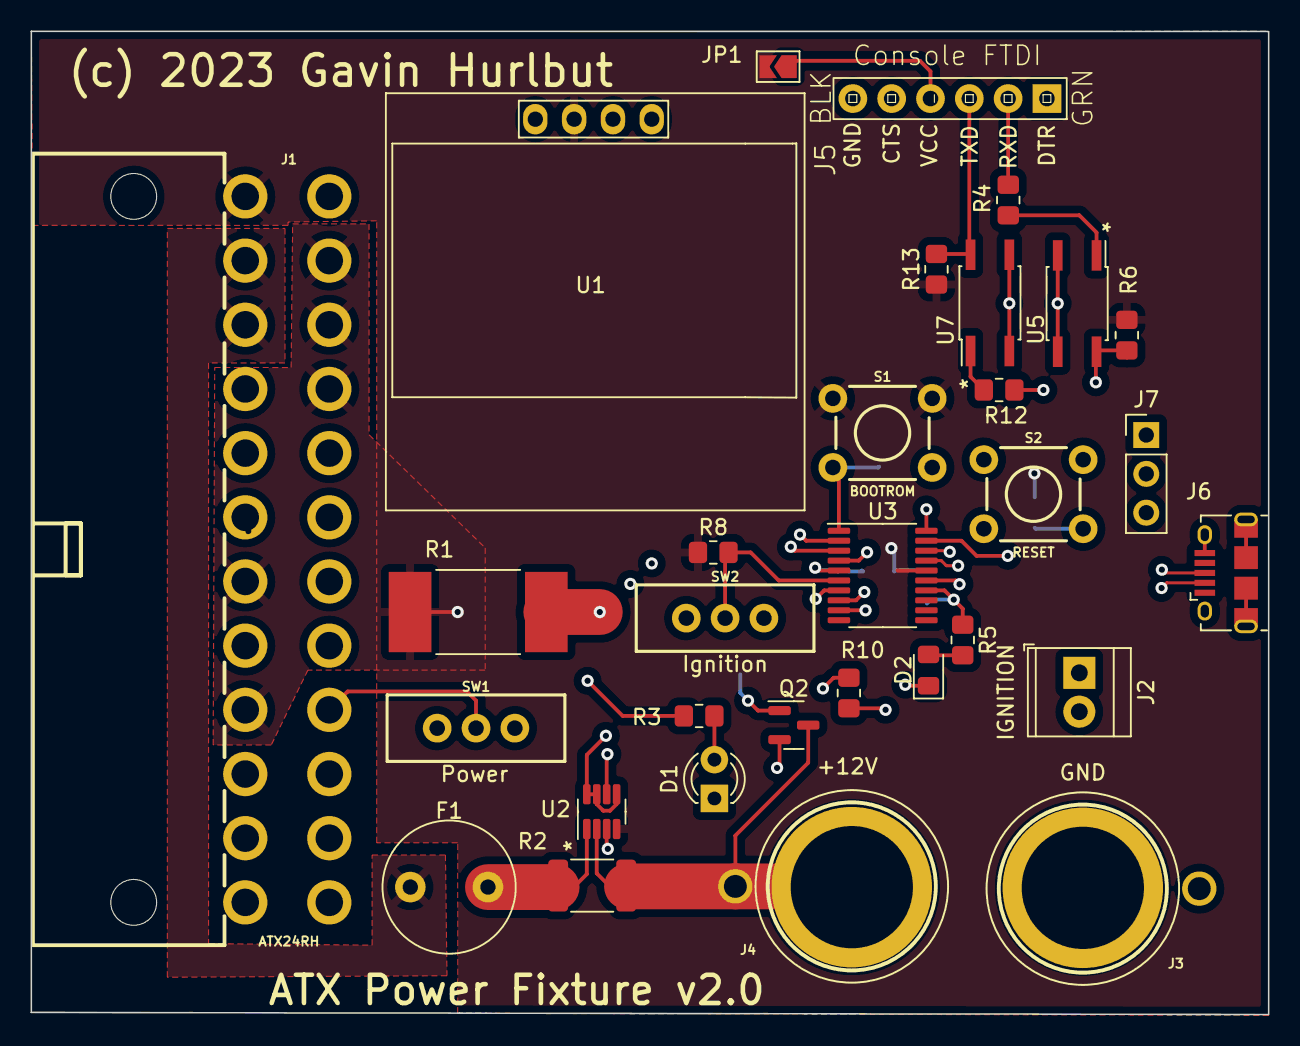
[picture p32: board atx-power-fixture.kicad_pcb from above]

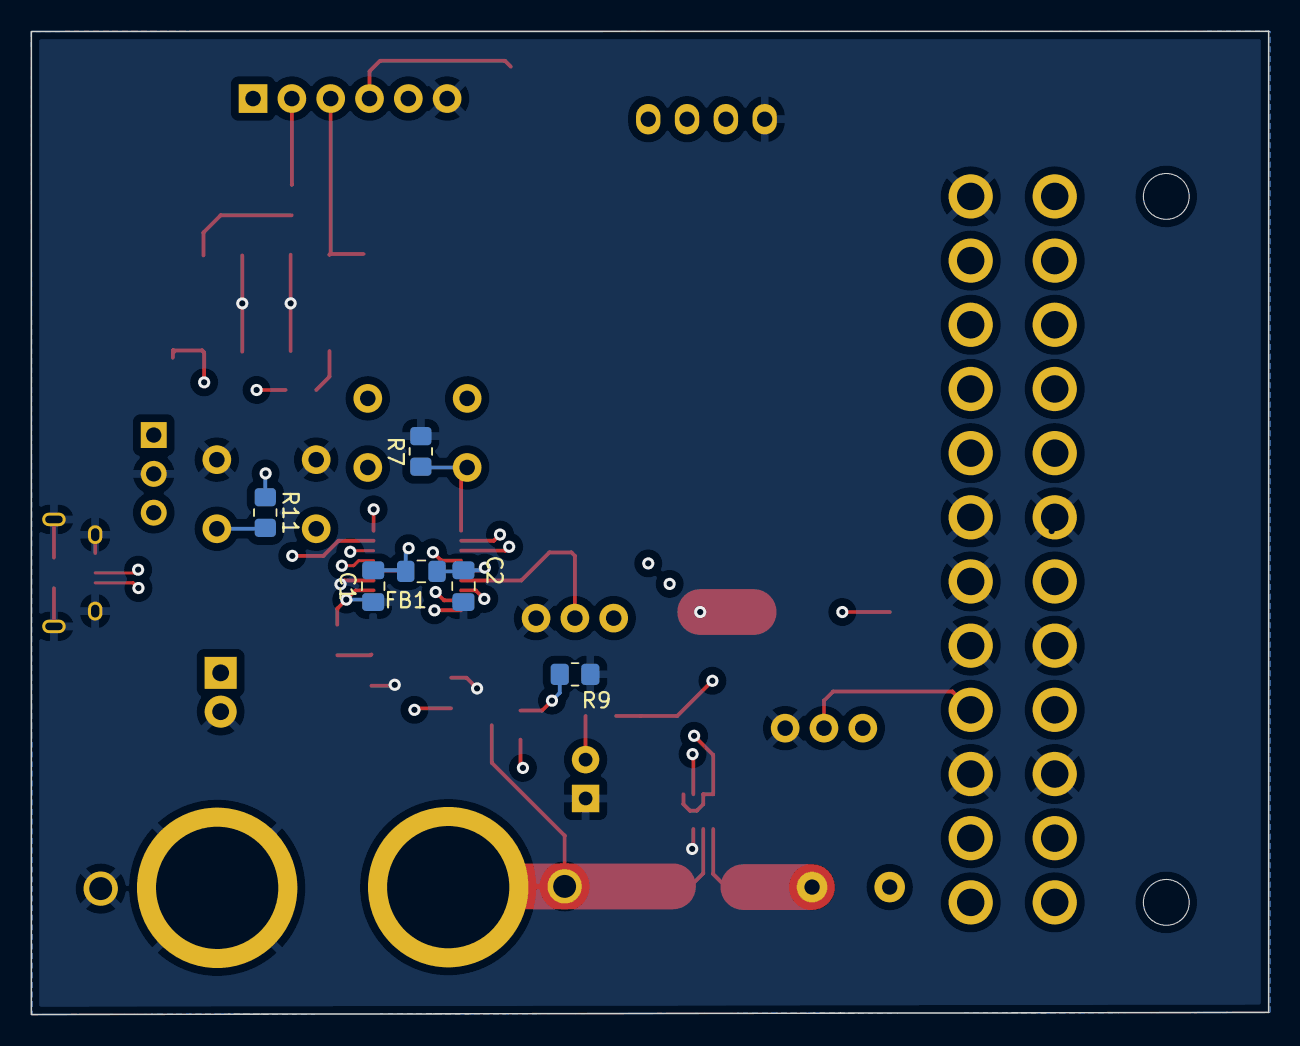
[picture p33: board atx-power-fixture.kicad_pcb from below]

Board: 4 copper layers, 81.0 x 64.3 mm, 37 parts (6 on the bottom side), 30 nets.
