Beirdo/arduino-webasto-mainboard/firmware/atx-power-fixture/src/global_timer.h

#ifndef __global_timer_h_
#define __global_timer_h_

#include <Arduino.h>

typedef void (*timer_callback)(int timer_id, int delay_ms);

struct timerItem_s;
typedef struct timerItem_s {
  int timer_id;
  int start_ms;
  int target_ms;
  timer_callback cb;
  struct timerItem_s *next;
} timerItem_t;

enum {
  TIMER_OLED_LOGO,
};

class GlobalTimer {
  public:
    GlobalTimer(void);
    void register_timer(int timer_id, int delay_ms, timer_callback cb);
    void adjust_timer(int timer_id, int delay_ms);
    void tick(void);
    int get_remaining_time(int timer_id);
  
  private:
    timerItem_t *find_item(int timer_id);
    timerItem_t *remove_item(int timer_id);
    void insert_item(timerItem_t *item);
  
    int _last_run;
    timerItem_t *_head;
};

extern GlobalTimer globalTimer;

#endif
