Beirdo/arduino-webasto-mainboard/firmware/webasto-mainboard/src/ina219.h

#ifndef __ina219_h_
#define __ina219_h_

#include "sensor.h"

class INA219Sensor : public LocalSensor {
  public:
    INA219Sensor(int id, uint8_t i2c_address, int bits, volatile bool *enable) :
      LocalSensor(id, 2, 20, bits, i2c_address), 
      _enable_signal(enable)
    {};

    void init(void);    
  protected:
    int32_t get_raw_value(void);
    int32_t convert(int32_t reading);
    void do_feedback(void);

    int _min_bits = 9;
    int _max_bits = 12;
    uint16_t _device_config;
    int _conv_us;
    volatile bool *_enable_signal;
};


#endif
