Beirdo/arduino-webasto-mainboard/(commit log)

2023-01-17 Update schematics. Had a better idea.
    [analog_io.kicad_sch, connectors.kicad_sch, digital_io.kicad_sch, power.kicad_sch, webasto-mainboard.kicad_sch]
2023-01-17 Split out the sensor board for analog sensors
    - Talks to the controller via I2C over a QWIIC chain.
    [analog_io.kicad_sch, connectors.kicad_sch, sensor-board.kicad_pcb, sensor-board.kicad_sch, webasto-mainboard.kicad_sch]
2023-01-17 More moving of stuff to sensor boards
    - not sure I have the glow plug part right quite yet.
    [analog_io.kicad_sch, digital_io.kicad_sch, webasto-mainboard.kicad_sch]
2023-01-18 Added QWIIC Interface schematic, more cleanup
    - redid all the MOSFET drives. The fan one still concerns me a bit.
    is it supposed to DRIVE a relay, or BE a relay? As long as it's a 12V
    relay, we should be good.
    [analog_io.kicad_sch, connectors.kicad_sch, digital_io.kicad_sch, qwiic-interface.kicad_pcb, qwiic-interface.kicad_sch, webasto-mainboard.kicad_sch]
2023-01-18 Added 1Wire sensor (over I2C) for outside temp
    - coded up the first AnalogSourceBase and DS2482Source classes
    - still need for ADC, thermocouple if... and internal temperature via
    internal ADC
    [sensor-board.kicad_sch]
2023-01-18 Added all the other sensor implementations
    - using classes in C++ is nice :)
    [digital_io.kicad_sch, webasto-mainboard.kicad_sch]
2023-01-19 v1.0 layout complete
    [connectors.kicad_sch, digital_io.kicad_sch, power.kicad_sch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]
2023-01-19 Layout v1 for sensors board
    [sensor-board-B_Cu.gbr, sensor-board-B_Mask.gbr, sensor-board-B_Paste.gbr, sensor-board-B_Silkscreen.gbr, sensor-board-Edge_Cuts.gbr, sensor-board-F_Cu.gbr, sensor-board-F_Mask.gbr, sensor-board-F_Paste.gbr]
2023-01-19 v1.0 of qwiic interface board layout
    [qwiic-interface-B_Cu.gbr, qwiic-interface-B_Mask.gbr, qwiic-interface-B_Paste.gbr, qwiic-interface-B_Silkscreen.gbr, qwiic-interface-Edge_Cuts.gbr, qwiic-interface-F_Cu.gbr, qwiic-interface-F_Mask.gbr, qwiic-interface-F_Paste.gbr]
2023-01-20 Added title block info
    [connectors.kicad_sch, digital_io.kicad_sch, power.kicad_sch, webasto-mainboard.kicad_sch]
2023-01-20 Added GPIO/EEPROM on sensor board
    - this will allow me to connect the ignition wire, and also to have the
    boards report their capabilities to the firmware
    [sensor-board-B_Cu.gbr, sensor-board-B_Mask.gbr, sensor-board-B_Paste.gbr, sensor-board-B_Silkscreen.gbr, sensor-board-Edge_Cuts.gbr, sensor-board-F_Cu.gbr, sensor-board-F_Mask.gbr, sensor-board-F_Paste.gbr]
2023-01-21 Added logging, added debug serial to mainboard
    - also added eeprom read support, and the digital GPIO over I2C
    - route the ignition wire as a digital GPIO so we can use it as an input
    to the state machine.
    [connectors.kicad_sch, digital_io.kicad_sch, power.kicad_sch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]
2023-01-22 Linked the KLine start/stop into the FSM
    - now ticking the timer too.
2023-01-22 Added a 4kbit FRAM on the mainboard to hold nonvolatile
    - things like burn hours.
    [connectors.kicad_sch, digital_io.kicad_sch, power.kicad_sch, webasto-mainboard.kicad_pcb, webasto-mainboard.kicad_sch]
2023-01-22 Add support for the NVM variables in the FRAM
    [webasto-mainboard.kicad_sch]
2023-01-23 Plumbed in more of the sensor info for kline
2023-01-23 Added EmergencyStop input. Hope I never need it.
    [connectors.kicad_sch, digital_io.kicad_sch, glow_plug.kicad_sch, power.kicad_sch, webasto-mainboard.kicad_pcb, webasto-mainboard.kicad_sch]
2023-01-23 Refactored timers to pass in/out the ID.
2023-01-23 Fix some bad whitespace (naughty!)
    [fsm_events.h]
2023-01-23 Oops. StartRun is active at +12V. Change the level translation.
    [digital_io.kicad_sch, glow_plug.kicad_sch, power.kicad_sch, webasto-mainboard.kicad_pcb, webasto-mainboard.kicad_sch]
2023-01-24 Added a couple LEDs, device info in "EEPROM"
2023-01-24 Oops, forgot to check in the schematic
    [webasto-mainboard.kicad_sch]
2023-01-24 Added the LEDs onto the board and init
    [connectors.kicad_sch, digital_io.kicad_sch, glow_plug.kicad_sch, power.kicad_sch, webasto-mainboard.kicad_pcb, webasto-mainboard.kicad_sch]
2023-01-24 Tweak routes to not go along bottom edge
    [webasto-mainboard.kicad_pcb]
2023-01-24 Check each sensor for connectivity
2023-01-24 Fix copyright date. 2013?!!?
    [webasto-mainboard.kicad_pcb]
2023-01-25 Filled out most of the rest (all?) of the FSM
    - added a piezo for alarms (like overheat!)
    [connectors.kicad_sch, digital_io.kicad_sch, glow_plug.kicad_sch, power.kicad_sch, webasto-mainboard.kicad_pcb, webasto-mainboard.kicad_sch]
2023-01-25 Update stats while running
    - still need to setup error lists.
    [fram.cpp, fram.h, fsm.cpp, fsm_state.h]
2023-01-25 Changed FSM to follow the "Webastardo" example
    - modified it slightly, of course
    - https://github.com/SimonRafferty/Webasto-Heater---Replacement-Controller/
    [fsm.cpp, fsm.h, fsm_events.h, fsm_state.h, fuel_pump.cpp, fuel_pump.h, global_timer.h, project.h]
2023-01-25 Plumbed in the adding of errors to error list
    - might not be complete yet.
    [fsm.cpp, fsm.h, fsm_events.h]
2023-01-25 Added beeps on each error and streams of beeps on lockdown
    [beeper.cpp, beeper.h, fram.cpp, fsm.cpp, fsm_state.h, global_timer.h, project.h]
2023-01-25 Plumbed in the LEDs.
2023-01-25 Added "USE_USB" input to choose console
    [connectors.kicad_sch, digital_io.kicad_sch, glow_plug.kicad_sch, power.kicad_sch, webasto-mainboard.kicad_pcb, webasto-mainboard.kicad_sch]
2023-01-25 Pull device info before I2C init, delay 1s for USB to connect.
2023-01-25 Changed solder pad style, added in the Sensor EEPROM init
    - of course, no boards hooked up yet, so it properly detects it.
    [sensor-board.kicad_pcb, sensor-board.kicad_sch]
2023-01-26 Added LCD display and a dummy sensor.
    - mucho debugging ensued
    - internal temperature is not working quite right.
    - FSM doesn't seem to init.
    [analog_source.cpp, analog_source.h, display.cpp, display.h, fram.cpp, fsm.cpp, fsm.h, fsm_state.h]
2023-01-26 Added the QWIIC5V-Shifter board
    - Seems the SerLCD requires 5V. All available shifters appear to be
    5V -> 3.3V. I need 3.3V -> 5V.
    - uses a charge pump regulator configured for 300mA @ 5V
    [qwiic5v-shifter.kicad_pcb, qwiic5v-shifter.kicad_sch]
2023-01-26 Forgot to mark the max current
    [qwiic5v-shifter.kicad_sch]
2023-01-27 Moved the KiCad libs to common spot
    - converted webasto-mainboard and regenerated gerbers
2023-01-27 Moved sensor-board over to the library, regenerated gerbers
    [sensor-board-B_Cu.gbr, sensor-board-B_Mask.gbr, sensor-board-B_Paste.gbr, sensor-board-B_Silkscreen.gbr, sensor-board-Edge_Cuts.gbr, sensor-board-F_Cu.gbr, sensor-board-F_Mask.gbr, sensor-board-F_Paste.gbr]
2023-01-27 Moved qwiic-interface over to shared lib, regenerated gerbers
    [qwiic-interface-B_Cu.gbr, qwiic-interface-B_Mask.gbr, qwiic-interface-B_Paste.gbr, qwiic-interface-B_Silkscreen.gbr, qwiic-interface-Edge_Cuts.gbr, qwiic-interface-F_Cu.gbr, qwiic-interface-F_Mask.gbr, qwiic-interface-F_Paste.gbr]
2023-01-27 Missed a spot
    [qwiic-interface.kicad_pcb]
2023-01-27 Moved qwiic5v-shifer to shared lib, generated gerbers
    [qwiic5v-shifter-B_Cu.gbr, qwiic5v-shifter-B_Mask.gbr, qwiic5v-shifter-B_Paste.gbr, qwiic5v-shifter-B_Silkscreen.gbr, qwiic5v-shifter-Edge_Cuts.gbr, qwiic5v-shifter-F_Cu.gbr, qwiic5v-shifter-F_Mask.gbr, qwiic5v-shifter-F_Paste.gbr]
2023-01-27 Update the KiCad lib
2023-01-27 Updated KiCad lib
2023-01-27 Added board sense, got FSM running, debugging
    - Have FSM and global timer running in Core1, and the sensor stuff in
    Core0
    - centralized the feedback to FSM, and made it wait until the FSM is
    initialized
    - actually START and initialize the FSM correctly
    - added in copious logging on state transitions, events
    - debugged the global timer (which currently gets a tick every 10ms)
    - debugged the internal temperature sensor: it's 3.3V Vref when there's
    nothing external feeding into it.
    - got the FRAM initialization in there, of course, no device yet.
    [webasto-mainboard.kicad_pcb, webasto-mainboard.kicad_sch]
2023-01-28 Make the display update once a second, fixed OLED screen layout
    [display.cpp, display.h, webasto-mainboard.ino]
2023-01-29 Got OLED working, found some deadlock-causing bugs
    - global timer insertion and deletion was a bit whacked. Ooops
    - added core number to the logs.
    - displays will now attempt to detect every second, but in absense, log
    at OLED resolution and setup.
    [display.cpp, display.h, global_timer.cpp, global_timer.h, oled_display.cpp, oled_display.h, project.h, webasto-mainboard.ino]
2023-01-29 Added some logging to kline, fixed a queueing misuse bug
    - KLine will be processed on Core1 as it is more idle than Core0
    [kline.cpp, project.h, webasto-mainboard.ino]
2023-01-29 Change VRef to 3.0 on board, add VSYS monitor from PICO
    [webasto-mainboard.kicad_sch]
2023-01-29 Change coolant sensor to a 10k NTC thermistor
    - this requires one more "TBD" resistor to be added to the board.
    - regenerated gerbers
    [sensor-board-B_Cu.gbr, sensor-board-B_Mask.gbr, sensor-board-B_Paste.gbr, sensor-board-B_Silkscreen.gbr, sensor-board-Edge_Cuts.gbr, sensor-board-F_Cu.gbr, sensor-board-F_Mask.gbr, sensor-board-F_Paste.gbr]
2023-01-30 Added code for programming sensor EEPROMs
    - Also updated kicad lib
2023-01-30 Changed DIP switch to solder jumper pads, regen gerbers
    [sensor-board-B_Cu.gbr, sensor-board-B_Mask.gbr, sensor-board-B_Paste.gbr, sensor-board-B_Silkscreen.gbr, sensor-board-Edge_Cuts.gbr, sensor-board-F_Cu.gbr, sensor-board-F_Mask.gbr, sensor-board-F_Paste.gbr]
2023-01-30 Start a new board to use an ATX power supply
    - saves keeping a car battery around
    - fusing at 8A on the 12V line.
    [atx-power-fixture.kicad_pcb, atx-power-fixture.kicad_sch, webasto-mainboard.kicad_sch]
2023-01-30 Layout + gerbers for ATX power fixture
    [atx-power-fixture-B_Cu.gbr, atx-power-fixture-B_Mask.gbr, atx-power-fixture-B_Paste.gbr, atx-power-fixture-B_Silkscreen.gbr, atx-power-fixture-Edge_Cuts.gbr, atx-power-fixture-F_Cu.gbr, atx-power-fixture-F_Mask.gbr, atx-power-fixture-F_Paste.gbr]
2023-01-31 Adding first run of firmware for the ATX board
    - displays shunt voltage, bus voltage, current, power
    [atx-power-fixture.kicad_pcb, atx-power-fixture.kicad_sch]
2023-01-31 Add in the beta equation method of calculating NTC temperature
2023-01-31 Moved the thermistor code into its own class for easier reuse
2023-01-31 Added snubbing diodes on all the inputs
    - back EMF from relays... I forgot... so reverse biased diodes from
    GND to signal and from signal to +12V.
    [connectors.kicad_sch, digital_io.kicad_sch, glow_plug.kicad_sch, power.kicad_sch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]
2023-01-31 Bumped a couple tracks. Regen gerbers
    [webasto-mainboard-B_Cu.gbr, webasto-mainboard-B_Mask.gbr, webasto-mainboard-B_Paste.gbr, webasto-mainboard-B_Silkscreen.gbr, webasto-mainboard-Edge_Cuts.gbr, webasto-mainboard-F_Cu.gbr, webasto-mainboard-F_Mask.gbr, webasto-mainboard-F_Paste.gbr]
2023-01-31 Fix NTC Thermistor calculations, and add timings
    - since a lookup with piecewise linear regression between entries
    is much much faster than the beta equation, and carries less than
    1% error, I'll be using that for now. The beta equation code will
    just sit there and watch.
    [display.cpp, kline.cpp, oled_display.cpp, webasto-mainboard.ino]
2023-01-31 Update title block on mainboard, print PDFs
    [connectors.kicad_sch, digital_io.kicad_sch, glow_plug.kicad_sch, power.kicad_sch, webasto-mainboard.kicad_pcb, webasto-mainboard.kicad_sch]
2023-01-31 Updated title block for sensor-board, add PDFs
    [sensor-board-B_Cu.gbr, sensor-board-B_Mask.gbr, sensor-board-B_Paste.gbr, sensor-board-B_Silkscreen.gbr, sensor-board-Edge_Cuts.gbr, sensor-board-F_Cu.gbr, sensor-board-F_Mask.gbr, sensor-board-F_Paste.gbr]
2023-01-31 Update title block for qwiic-interface, add PDFs
    [qwiic-interface-B_Cu.gbr, qwiic-interface-B_Mask.gbr, qwiic-interface-B_Paste.gbr, qwiic-interface-B_Silkscreen.gbr, qwiic-interface-Edge_Cuts.gbr, qwiic-interface-F_Cu.gbr, qwiic-interface-F_Mask.gbr, qwiic-interface-F_Paste.gbr]
2023-01-31 Added title block info, added PDFs
    [qwiic5v-shifter-B_Cu.gbr, qwiic5v-shifter-B_Mask.gbr, qwiic5v-shifter-B_Paste.gbr, qwiic5v-shifter-B_Silkscreen.gbr, qwiic5v-shifter-Edge_Cuts.gbr, qwiic5v-shifter-F_Cu.gbr, qwiic5v-shifter-F_Mask.gbr, qwiic5v-shifter-F_Paste.gbr]
2023-01-31 Add title block info, add PDFs
    [atx-power-fixture-B_Cu.gbr, atx-power-fixture-B_Mask.gbr, atx-power-fixture-B_Paste.gbr, atx-power-fixture-B_Silkscreen.gbr, atx-power-fixture-Edge_Cuts.gbr, atx-power-fixture-F_Cu.gbr, atx-power-fixture-F_Mask.gbr, atx-power-fixture-F_Paste.gbr]
2023-01-31 Fixed the binding posts to have HOLES in them
    [atx-power-fixture-B_Cu.gbr, atx-power-fixture-B_Mask.gbr, atx-power-fixture-B_Paste.gbr, atx-power-fixture-B_Silkscreen.gbr, atx-power-fixture-Edge_Cuts.gbr, atx-power-fixture-F_Cu.gbr, atx-power-fixture-F_Mask.gbr, atx-power-fixture-F_Paste.gbr]
2023-01-31 Tried to shrink the board to < 100mm long. Failed
    [atx-power-fixture-B_Cu.gbr, atx-power-fixture-B_Mask.gbr, atx-power-fixture-B_Paste.gbr, atx-power-fixture-B_Silkscreen.gbr, atx-power-fixture-Edge_Cuts.gbr, atx-power-fixture-F_Cu.gbr, atx-power-fixture-F_Mask.gbr, atx-power-fixture-F_Paste.gbr]
2023-02-01 Template map and clamp
2023-02-05 Move the gates of the level translators to the lowside signal
    [qwiic5v-shifter-B_Cu.gbr, qwiic5v-shifter-B_Mask.gbr, qwiic5v-shifter-B_Paste.gbr, qwiic5v-shifter-B_Silkscreen.gbr, qwiic5v-shifter-Edge_Cuts.gbr, qwiic5v-shifter-F_Cu.gbr, qwiic5v-shifter-F_Mask.gbr, qwiic5v-shifter-F_Paste.gbr]
2023-02-06 Add beginnings of support for LINBus bridge board
2023-02-07 Someone put the ATX connector on back-asswards. Ooops.
    [atx-power-fixture-B_Cu.gbr, atx-power-fixture-B_Mask.gbr, atx-power-fixture-B_Paste.gbr, atx-power-fixture-B_Silkscreen.gbr, atx-power-fixture-Edge_Cuts.gbr, atx-power-fixture-F_Cu.gbr, atx-power-fixture-F_Mask.gbr, atx-power-fixture-F_Paste.gbr]
2023-02-10 Add bare board pic
2023-02-10 Redid the transparency on the replacement board
2023-02-10 Moved emerg. shutdown offboard
    [connectors.kicad_sch, digital_io.kicad_sch, glow_plug.kicad_sch, power.kicad_sch, webasto-mainboard.kicad_pcb, webasto-mainboard.kicad_sch]
2023-02-13 Fix trailing white space
    [analog_source.cpp, beeper.cpp, beeper.h, device_eeprom.cpp, device_eeprom.h, display.cpp, display.h, fram.cpp]
2023-02-15 OK, can't use digitalRead on the shared line.
    - for now, VSYS is not being monitored
    - Wifi comes up fine, connection to server comes up, and will reconnect
    if interrupted, but never send more data after reconnection, so I still
    have a logic glitch in there.
    - I have all WiFi access on Core1 now.
    [global_timer.cpp, global_timer.h, internal_adc.cpp]
2023-02-15 And now the onboard LED (attached to the WiFi chip) works
2023-02-15 Got rid of TINY diode (0402!?!?), remove USE_USB, put in PicoW
    [connectors.kicad_sch, digital_io.kicad_sch, glow_plug.kicad_sch, power.kicad_sch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]
2023-02-15 Switch the ATX board to use Pico W
    [atx-power-fixture-B_Cu.gbr, atx-power-fixture-B_Mask.gbr, atx-power-fixture-B_Paste.gbr, atx-power-fixture-B_Silkscreen.gbr, atx-power-fixture-Edge_Cuts.gbr, atx-power-fixture-F_Cu.gbr, atx-power-fixture-F_Mask.gbr, atx-power-fixture-F_Paste.gbr]
2023-02-15 Update the program-sensor-boards firmware
2023-02-21 Plumb in talking to the LINBus sensors via the LINBus bridge
    - no feedback loop yet, and nothing actually controlling yet
    [qwiic-interface.kicad_sch]
2023-02-22 Fix the corenum output.
    - oddly, this seems to crap out after a while too. Not sure why
    yet.
    [webasto-mainboard.ino]
2023-02-22 Move VSYS to ADC2 to avoid the stupid WiFi setup
    [connectors.kicad_sch, digital_io.kicad_sch, glow_plug.kicad_sch, power.kicad_sch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]
2023-02-23 Move the LED to the mainboard
    - due to how the driver doesn't share the SPI bus well, you currently can
    either use the TCP stack or the GPIOs. Mixing will cause weird crashes.
    - so I'm adding the LED onto the mainboard directly.
    [connectors.kicad_sch, digital_io.kicad_sch, glow_plug.kicad_sch, power.kicad_sch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]
2023-02-23 Added more ngspice, add active_low to the PCA9501
    - also disabled the hex dump on cbor tx
    - trying to get this to just WORK and not take a dump in the bed after
    a while.
    [CSD22204W.OLB]
2023-02-24 Move start/run to sensor board, add CANBUS
    - WiFi is not being very helpful, and I'm concerned it won't work well once
    installed in the bus... CANBus wiring is easy.
    - Removed both Start/Run and the Vehicle Fan Relay from X1 to make space for
    canbus
    - moved LEDs onto an I2C gpio extender.
    - will need to still plumb in CAN_EN support
    - will also need to yank out the WiFi stuff that won't stay stable anyways
    and reroute the CBOR out the CANBus instead of WiFi
    - Vehicle Fan control will need to move to a LINBus fan controller board
    [canbus.kicad_sch, connectors.kicad_sch, digital_io.kicad_sch, glow_plug.kicad_sch, power.kicad_sch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]
2023-02-25 First rev of CANBus-connected Thermistor Board
    - will be used as templater for others
    [canbus-thermistor.kicad_pcb, canbus-thermistor.kicad_sch]
2023-02-25 Add CANBus Thermistor layout
    [canbus-thermistor-B_Cu.gbr, canbus-thermistor-B_Mask.gbr, canbus-thermistor-B_Paste.gbr, canbus-thermistor-B_Silkscreen.gbr, canbus-thermistor-Edge_Cuts.gbr, canbus-thermistor-F_Cu.gbr, canbus-thermistor-F_Mask.gbr, canbus-thermistor-F_Paste.gbr]
2023-02-25 Moved KiCad git libraries to a new repo
    - https://github.com/Beirdo/KiCad-Git-Libraries
2023-02-25 Moved to https://github.com/Beirdo/misc-boards
    [qwiic-interface-B_Cu.gbr, qwiic-interface-B_Mask.gbr, qwiic-interface-B_Paste.gbr, qwiic-interface-B_Silkscreen.gbr, qwiic-interface-Edge_Cuts.gbr, qwiic-interface-F_Cu.gbr, qwiic-interface-F_Mask.gbr, qwiic-interface-F_Paste.gbr]
2023-02-26 Remove WiFi, plumb in the CANBus
    - The next joy will be to remove the external I2C, and have all the
    sensors talk to us via CANBus as well.
    - First I need to determine how to restructure to enumerate my sensors
    - Nice thing is, the sensors will share an ID space across the bus
    (including LINBus, which will now need rework too)
    [canbus.kicad_sch]
2023-02-26 Add plumbing for receiving sensor values from CANBus
2023-02-26 Moved the canbus IDs to the common lib
2023-02-26 Converted local sensors to new scheme
    - kinda rethinking the use of the templating though, it gets
    messy real fast.
2023-02-27 Removed all the remote sensors. All CANBus normal code in place.
2023-02-27 Copy in thermistor and ADC code from old design to new
2023-02-28 Added first run of code for the canbus-thermistor
    - need to add filtering and actual dispatch
2023-02-28 Added CAN filtering
2023-02-28 Add the dispatcher for thermistor board
2023-02-28 Add canbus-gpios board (templated from canbus-thermistor)
    [canbus-gpios.kicad_pcb, canbus-gpios.kicad_sch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]
2023-02-28 Updated canbus-gpios to do GPIOs
    - START_RUN and IGNITION_SENSE are active high 12V.
    - EMERGENCY_STOP is active low 12V.
    - all GPIOs converted to active high 3.3V at the CPU
    [canbus-gpios-B_Cu.gbr, canbus-gpios-B_Mask.gbr, canbus-gpios-B_Paste.gbr, canbus-gpios-B_Silkscreen.gbr, canbus-gpios-Edge_Cuts.gbr, canbus-gpios-F_Cu.gbr, canbus-gpios-F_Mask.gbr, canbus-gpios-F_Paste.gbr]
2023-02-28 Add firmware for canbus-gpios
2023-02-28 Templated out the canbus-ds1820 hardware
    [canbus-ds1820.kicad_pcb, canbus-ds1820.kicad_sch]
2023-02-28 Updated canbus-ds1820 board, reannotated canbus-gpios
    [canbus-ds1820-B_Cu.gbr, canbus-ds1820-B_Mask.gbr, canbus-ds1820-B_Paste.gbr, canbus-ds1820-B_Silkscreen.gbr, canbus-ds1820-Edge_Cuts.gbr, canbus-ds1820-F_Cu.gbr, canbus-ds1820-F_Mask.gbr, canbus-ds1820-F_Paste.gbr]
2023-02-28 Added firmware for canbus-ds1820 board
2023-02-28 Spun off canbus-thermocouple
    [canbus-thermocouple.kicad_pcb, canbus-thermocouple.kicad_sch]
2023-02-28 Updated the thermocouple board, added OSHW to bottom of all boards
    [canbus-ds1820.kicad_pcb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]
2023-02-28 Added firmware for thermocouple board
2023-02-28 Remove sensor-board entirely
    [sensor-board-B_Cu.gbr, sensor-board-B_Mask.gbr, sensor-board-B_Paste.gbr, sensor-board-B_Silkscreen.gbr, sensor-board-Edge_Cuts.gbr, sensor-board-F_Cu.gbr, sensor-board-F_Mask.gbr, sensor-board-F_Paste.gbr]
2023-03-01 Moved all canbus over to new repo
    - https://github.com/Beirdo/skoolie-canbus-sensors
    [canbus-ds1820-B_Cu.gbr, canbus-ds1820-B_Mask.gbr, canbus-ds1820-B_Paste.gbr, canbus-ds1820-B_Silkscreen.gbr, canbus-ds1820-Edge_Cuts.gbr, canbus-ds1820-F_Cu.gbr, canbus-ds1820-F_Mask.gbr, canbus-ds1820-F_Paste.gbr]
2023-03-01 Plumb in the beginnings of the LINBus sensors
2023-03-04 Moved the INA219 into my own library
    [glow_plug.kicad_sch]
2023-03-04 Rejigger the mainboard to use voltage regulator
    [canbus.kicad_sch, connectors.kicad_sch, digital_io.kicad_sch, glow_plug.kicad_sch, power.kicad_sch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]
2023-03-05 Moving this to PlatformIO. Arduino IDE is annoying me.
2023-03-06 Trim out the fat (CBOR, parts of WBUS)
    - the sensor part of WBUS is handled by the canbus-kline-bridge
    board as the values are flying over the CANBus anyways.
2023-03-07 Converted atx-power-fixture to PlatformIO, and to STM32F042F6
    [atx-power-fixture-B_Cu.gbr, atx-power-fixture-B_Mask.gbr, atx-power-fixture-B_Paste.gbr, atx-power-fixture-B_Silkscreen.gbr, atx-power-fixture-Edge_Cuts.gbr, atx-power-fixture-F_Cu.gbr, atx-power-fixture-F_Mask.gbr, atx-power-fixture-F_Paste.gbr]
2023-03-07 Move the submodules for ats-power-fixture into the platformio.ini
2023-03-08 Removing KLine and I2C from X1, reattaching the external IOs.
    [canbus.kicad_sch, connectors.kicad_sch, digital_io.kicad_sch, glow_plug.kicad_sch, power.kicad_sch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]
