Beirdo/arduino-webasto-mainboard/(notices)

Notices in the files:
hardware/webasto-mainboard/webasto-mainboard.kicad_pcb:
(c) 2023 Gavin Hurlbut
parts and their libraries:
Copyright 2021 Accelerated Designs. All rights reserved.
